rjiuzzol/True8Digit/README.md

# True8Digit
File repository for True8Digit project
