rjiuzzol/True8Digit/Documents/Main_copa_report_v2.pdf

## True8Digit project: COPA input amplifier characterization

Ricardo Iuzzolino¹ and Luis Palafox²

1
Instituto Nacional de Tecnolog´ıa Inductrial (INTI) - Argentina 2Physikalisch-Technische Bundesanstalt (PTB) - Germany

August 2024

## Contents

1 Introduction | 1
2 Test on Board #2 | 2
3 Tests on Board #1 | 3
4 Modification: changing the TL071 with OPA1655 | 10
5 Summary | 11
6 Appendix | 12

## 1 Introduction

Two identical boards were designed by INTI, built by CTU and delivered to PTB for testing:

Board #1

Board #2

Both boards are based on the schematic circuit depicted in figure 1, the original schematic circuit can be seen at reference [3]. The circuit is based on the original input amplifier of the DVM HP3458A [2].

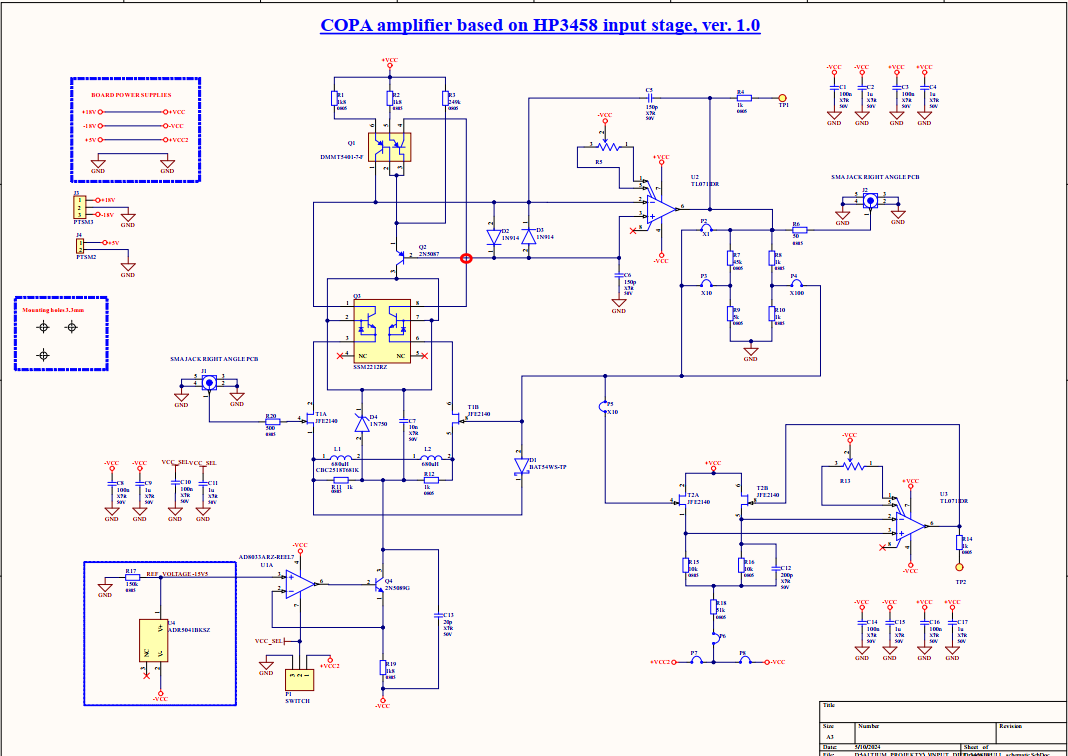
[picture p1: figure]

Figure 1: Schematic circuit based on LTSpice schematic ([3] and [1])

## 2 Test on Board #2

The gain, phase and total harmonic distortion (THD) as a function of input frequency were measured using the Audio Precision APx555 audio analyzer. Because on the of the digitizing channels is modified to have a high input impedance, the tests were run using channel two which has input impedance of 300 Ω, 600 Ω and 100 kΩ, therefore two sets of measures were done interchanging input and output channels. The APx555 offers the possibility of combining the peak of one acquisition with the rest of the spectrum acquired after a tuneable notch filter is adjusted to the measured frequency, thereby eliminating harmonics generated by the input stage of the digitizer.

### 2.1 Gain and Phase

A frequency sweep was set in order to obtain the gain and phase of the COPA amplifier, starting from 20 kHz down to 20 Hz in a linear sweep of 2000 points in total, keeping the signal amplitude fixed to the full scale value of 7.071 V to cover the full input range between ± 10 V.

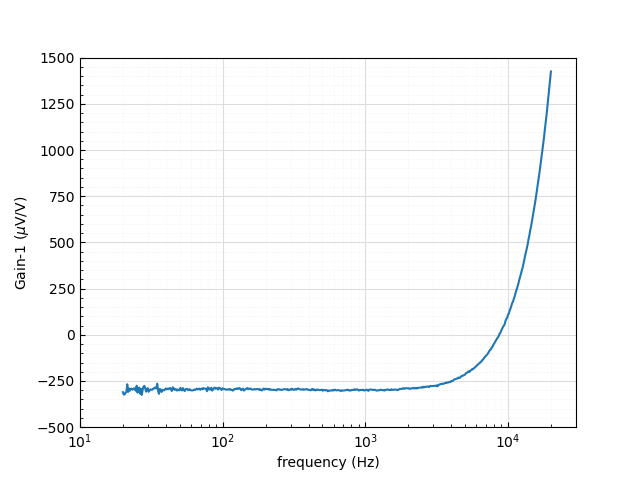
[picture p2: figure]
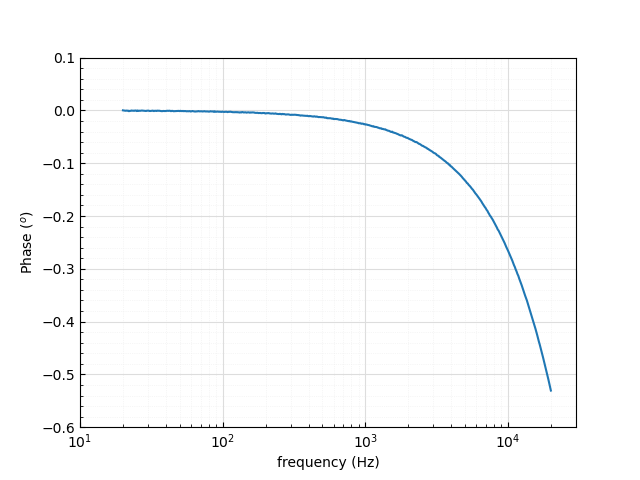
[picture p3: figure]

(a) COPA amplifier board #2 measured gain | (b) COPA amplifier board #2 phase response

### 2.2 Total Harmonic Distortion

To measure and estimate the total harmonic distortion, the APx555 channel 2 was used to measured first the input and then the output at the frequencies listed in table 1. A full scale amplitude signal was applied to the amplifier input, that is an RMS amplitude of 7.071 V, then the THD was obtained taking into account up to the 5th harmonic.

Table 1: Harmonic Distortion results for the input and output of the amplifier including the bandwidth resulting from the sampling rate used.

Freq (Hz) | Input THD (dB) | Output THD (dB) | Bandwidth
62.5 125 625 1000 2000 5000 10000 20000 | -150.41 -147.16 -149.28 -146.91 -142.02 -136.02 -130.61 -126.16 | -143.59 -138.61 -127.87 -123.81 -117.43 -108.56 -99.00 -88.38 | DC-90 kHz
50000 100000 | -118.43 -109.37 | -73.15 -46.15 | DC-500 kHz

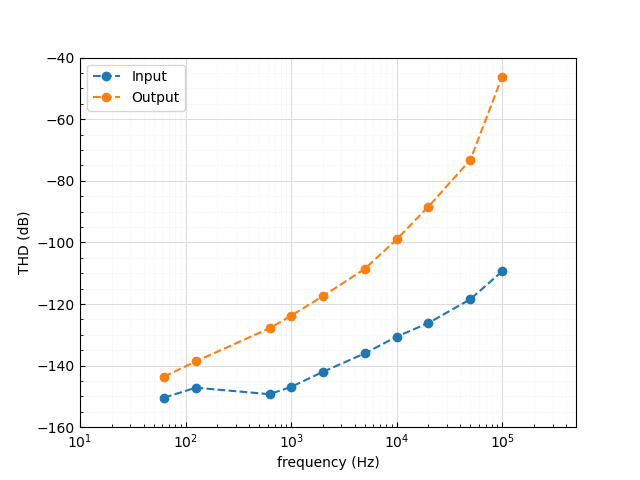
[picture p4: figure]

Figure 3: Total Harmonic Distortion of the circuit in figure 1 as a function of frequency

## 3 Tests on Board #1

Board #1 was modified as follows: the gain setting feedback resistors were removed, therefore only Gain = 1 is possible, the bootstrap circuit was disconnected from the main amplifier output because the BOOT signal is not routed on the PCB. Figure 4 depicts the circuit.

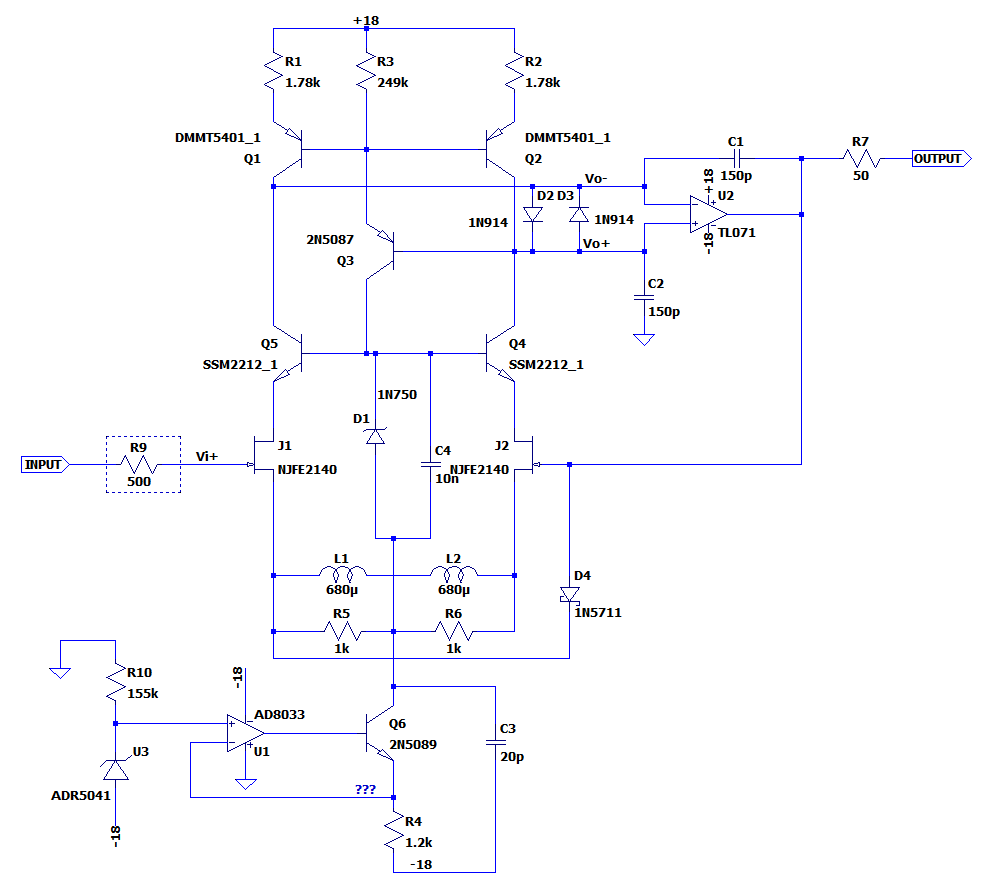
[picture p5: figure]

Figure 4: Schematic circuit of modified board #1

### 3.1 Gain and Phase

A linear frequency sweep with 2000 points was performed in order to obtain the response of the COPA amplifier, starting from 20 kHz down to 20 Hz, keeping the signal amplitude fixed to the full scale value of 7.071 V to cover the full input range between ± 10 V.

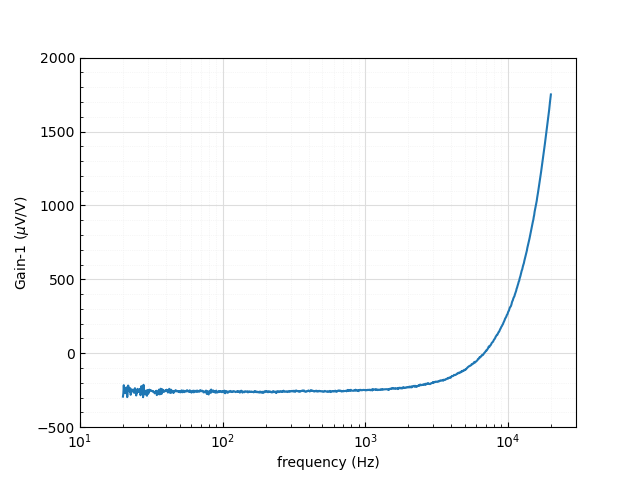
[picture p6: figure]
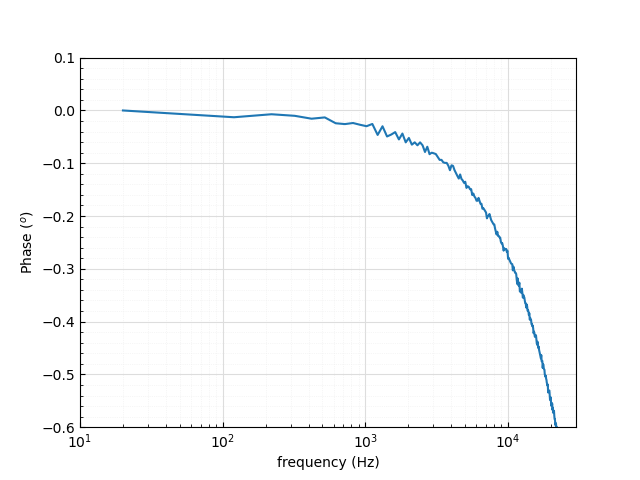
[picture p7: figure]

(a) COPA amplifier board #1 measured gain | (b) COPA amplifier board #1 phase response

### 3.2 Total Harmonic Distortion

The Total harmonic distortion test using up to the 5th harmonic was also performed for board #1. And was calculated using the same criteria as in section 2.2.

Table 2: Harmonic Distortion results for the input
and output of the amplifier including the bandwidth resulting from the sampling rate used.
Freq (Hz) (Hz) | Input THD (dB) | Output THD (dB) | Bandwidth
62.5 125 625 1000 2000 5000 10000 20000 | -151.22 -147.47 -151.36 -147.92 -142.79 -135.40 -130.60 -125.85 | -148.51 -144.36 -137.55 -134.14 -127.30 -115.48 -103.88 -92.42 | DC-90 kHz
50000 100000 | -118.87 -109.63 | -76.48 -45.13 | DC-500 kHz

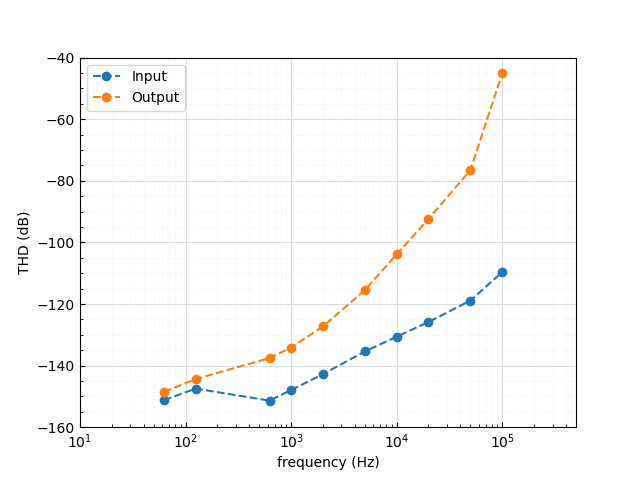
[picture p8: figure]

Figure 6: Total Harmonic Distortion as a function of frequency

### 3.2.1 Total Harmonic Distortion - Comparison

Figure 7 shows the THD of both boards, it is clear to see the improvements when removing the gain resistors and disconnecting the bootstrap circuit.

Table 3: Total Harmonic Distortion differences. THD 1 - THD 2

freq. (Hz) | Diff. (dB)
62.5 125 625 1000 2000 5000 10000 20000 50000 | 4.92 5.75 9.68 10.33 9.87 6.92 4.88 4.04 3.34

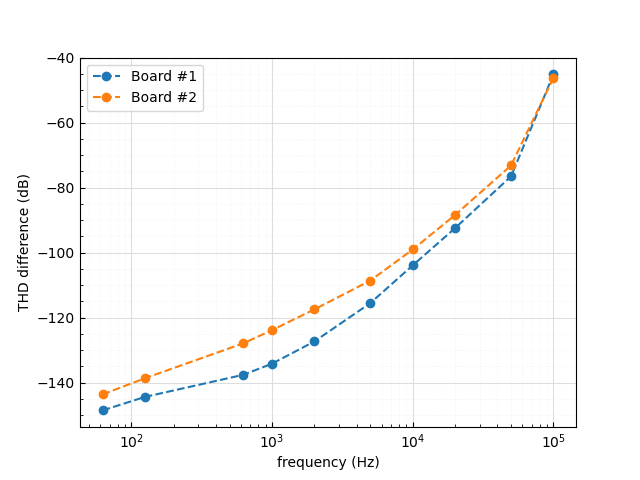
[picture p9: figure]

100000 | -1.02 | Figure 7: Board #1 and board #2 THD compar- ison

### 3.2.2 Harmonic distortion at different input signal levels

In order to characterize the harmonic distortion at different input signal frequencies and levels a test changing the input signal level while keeping the signal frequency constant was carried out as depicted in figure 8 for frequencies between 5 kHz and 100 kHz.

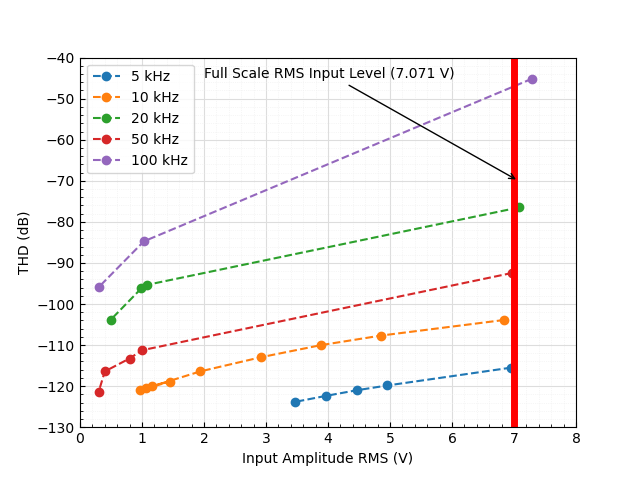
[picture p10: figure]

Figure 8: Total harmonic distortion vs. input signal level

### 3.2.3 Loading effect in the output spectrum

In order to evaluate the effect of loading at the output of the amplifier, the input impedance of the APx55 digitizer was changed between 600 Ω and 100 kΩ. The output spectra are depicted in figure 9

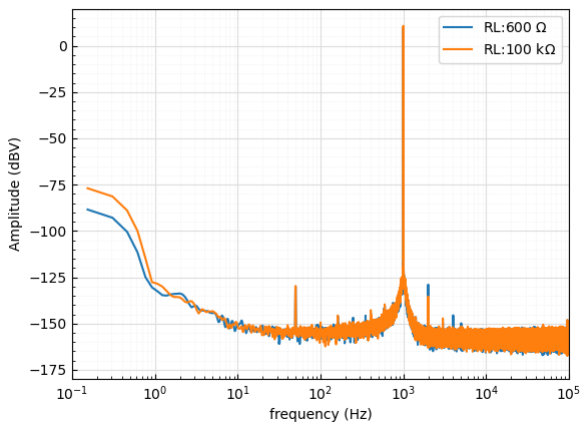
[picture p11: figure]
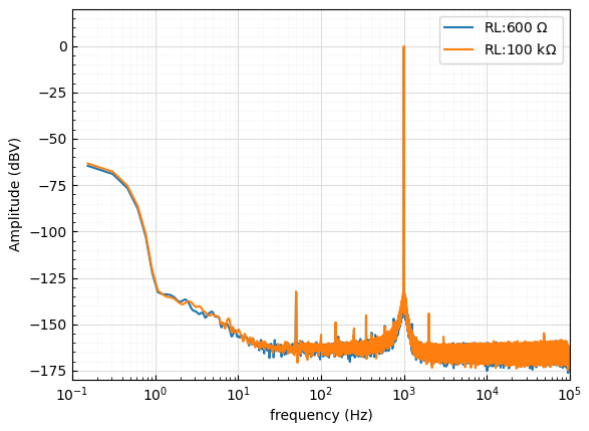
[picture p12: figure]

(a) Amplifier Spectrum Input Level 1 V | (b) Amplifier Spectrum Input Level 3.5 V

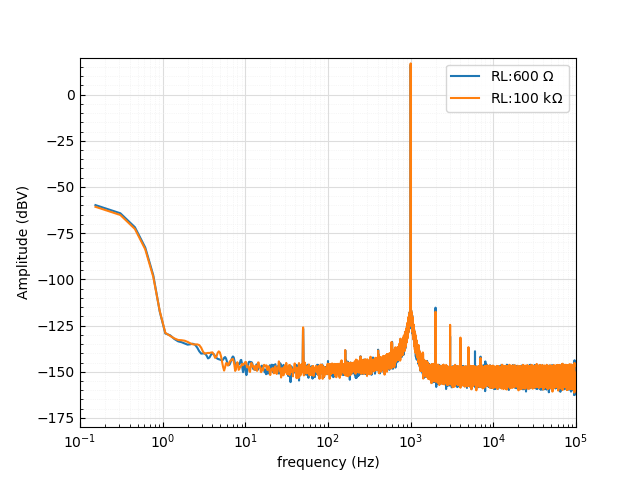
[picture p13: figure]

(c) Amplifier Spectrum Input Level 7.07 V

Figure 9: COPA Amplifer spectra at different loads values and input amplitudes

Test results are shown in table 4 where the input signal amplitude was set to 1 V RMS, in table 5 were the input amplitude was set to 3.5 V RMS and in table 6 were the input amplitude was set to 7.07 V RMS which corresponds to the amplifier full scale. The intermediate level was chosen to match the full scale value of the AD4630-24 SAR also analyzed in the project.

Table 4: Output levels at different frequencies for an input amplitude 1 V at 600 Ω and 100 kΩ loads

Harm. # | Freq (Hz) | 100 kΩ | 600 Ω | Delta
| | Amp (dB) | Amp | Amp (dB) | Amp
fo 2fo 3fo 4fo | 1000.20 2000.20 3000.30 4000.10 | -0.12816 -144.15 -156.63 -162.09 | 0.985353 V 62 nV 14.7 nV 7.86 nV | -0.82809 -149.05 -159 -162.08 | 0.909066 V 35.3 nV 11.2 nV 7.87 nV | 76 mV 26.7 nV 3.52 nV -4.48 pV

Table 5: Output levels at different frequencies for an input amplitude 3.5 V at 600 Ω and 100 kΩ loads

Harm. # | Freq (Hz) | 100 kΩ | 600 Ω | Delta
| | Amp (dB) | Amp | Amp (dB) | Amp
fo 2fo 3fo 4fo | 1000.15 2000.15 3000.30 4000.46 | 10.748 -135.39 -147.197 -154.121 | 3.446672 V 170 nV 43.7 nV 19.7 nV | 10.049 -128.985 -149.577 -145.531 | 3.180168 V 355 nV 33.2 nV 52.9 nV | 267 mV -185 nV 10.5 nV -33.2 nV

Table 6: Output levels at different frequencies for an input amplitude 7.07 V at 600 Ω and 100 kΩ loads

Harm. # | Freq (Hz) | 100 kΩ | 600 Ω | Delta
| | Amp (dB) | Amp | Amp (dB) | Amp
fo 2fo 3fo 4fo | 1000.15 2000.15 3000.30 4000.46 | 16.859 -117.537 -124.607 -131.498 | 6.965463 V 1.33 µV 0.588 µV 0.266 µV | 16.158 -115.307 -130.852 -135.219 | 6.425398 V 1.72 µV 0.287 µV 0.173 µV | 540 mV -389 nV 302 nV 92.7 nV

### 3.3 Noise

### 3.3.1 Equivalent input voltage noise

The input noise of the APx555 is comparable to the expected noise from the COPA, therefore PTB’s PA3 was used to amplify the noise of the COPA and connected as follows: the COPA amplifier input was shorted and the output connected to a pre-amplifier (PTB PA3 Ultra Low Noise AC pre-amplifier) running both on batteries. The PTB PA3 on its internal batteries and the COPA powered by a ±12 V battery pack. The PA3 output was connected to CH2 sampler. The AP software was configure to sample the data at 192 kHz (bandwidth DC to 90 kHz), averaging 64 windows of 1.2 M data points with rectangular windows (no window function on the software).
PA3 nominal gain = x60, measured gain = x59.2 and voltage noise = 0.53 nV/√
Hz. PA3 voltage
noise is shown in figure 11, as can be seen its noise level does not affect COPA noise measurements. Figure 10a shows the Amplitude Spectrum Density of the measured signal divided by the PA3 gain factor. The noise level at 1 kHz was determined to be 3.9 nV/√
Hz.

### 3.3.2 Equivalent input current noise

The short circuit in the above setup was substituted with a 100 MΩ resistor. Figure 10b shows the Amplitude Spectrum Density of the measured signal divided by the PA3 gain factor and 100 MΩ resistance. The current noise level at 1 kHz was determined to be 6.6 fA/√
Hz.

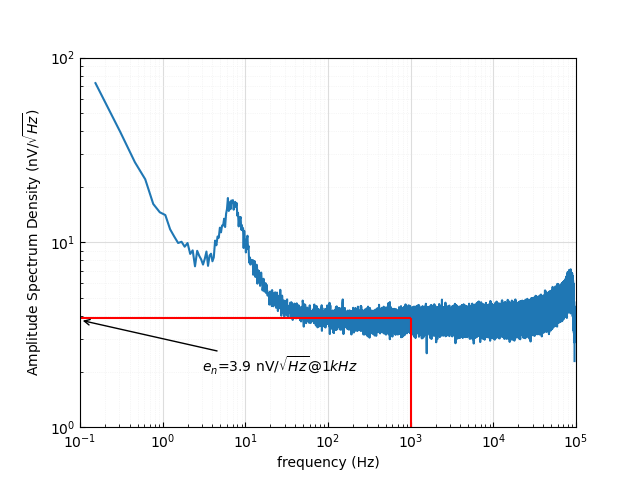
[picture p14: figure]
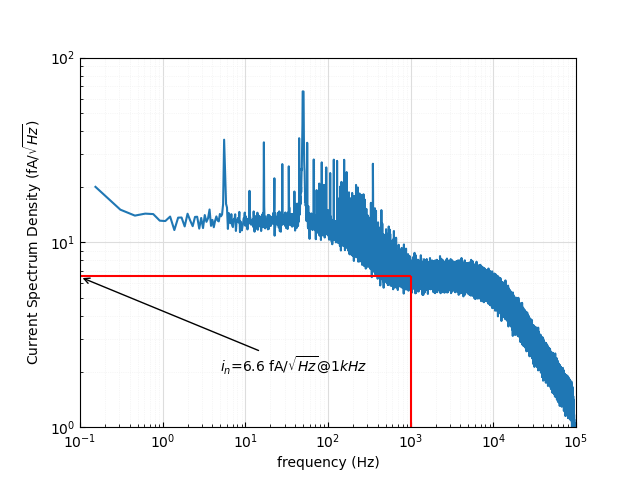
[picture p15: figure]

(a) COPA amplifier board #1 input voltage noise | (b) COPA amplifier board #1 input current noise

Figure 10: Amplifer voltage and current input reference noise

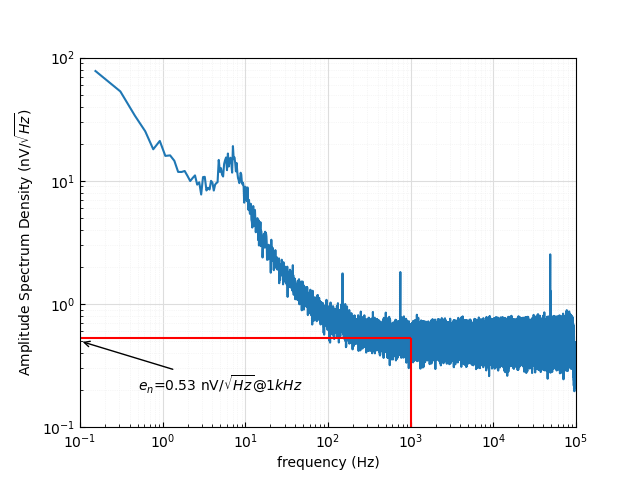
[picture p16: figure]

Figure 11: PA3 amplifier input voltage noise

### 3.4 Input Impedance

The input impedance was measured adding an external 100 MΩ in series between the output of the APx555 and the input of the COPA. and calculating the amplifier input current and voltage. The input voltage applied was 5 V RMS, then the amplifier input and output were measured by the AP on channel 2 in two steps: i) performing a frequency sweep from 20 Hz to 20 kHz (digitizer BW 90 kHz), ii) a second frequency sweep from 10 kHz up to 100 kHz (digitizer BW 250 kHz). Results are shown in figure 12 and table 7. The low frequency input impedance value results in 920.31 MΩ. Modelling the input impedance as an RC parallel circuit and performing a fitting to zero frequency an input resistance, Ri

, of 1.3645 GΩ and an input capacitance, Ci of 6.384 pF were determined.

Table 7: Board #1 Input Impedance

Freq (Hz) | Zi (MΩ)
20 1000 10000 20000 50000 100000 | 920.31 18.56 2.22 1.50 1.20 1.17

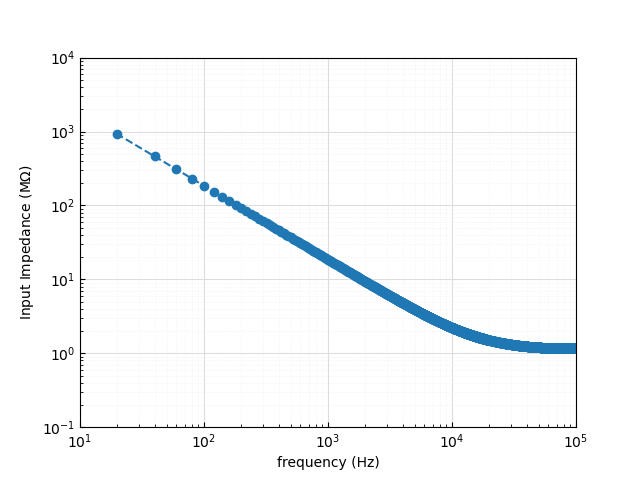
[picture p17: figure]

Figure 12: Board #1 input impedance in the frequency range from 20 Hz up to 100 kHz

Table 8: Input RC

Ri (GΩ) | Ci (pF)
1.364 | 6.38

### 3.5 Settling time

In order to obtain the amplifier settling time, a Keithley function generator was used as source, then the amplifier input and output were captured using a high bandwidth and high resolution digital scope

LeCroy, HDO4054, setting its digital filters to +3 bits which corresponds to a high resolution value. A squarewave signal with a peak-to-peak amplitude of 10 V and frequency of 10 kHz was used to observe and calculated the settling time. In addition, the rise-time and fall-time were calculated.

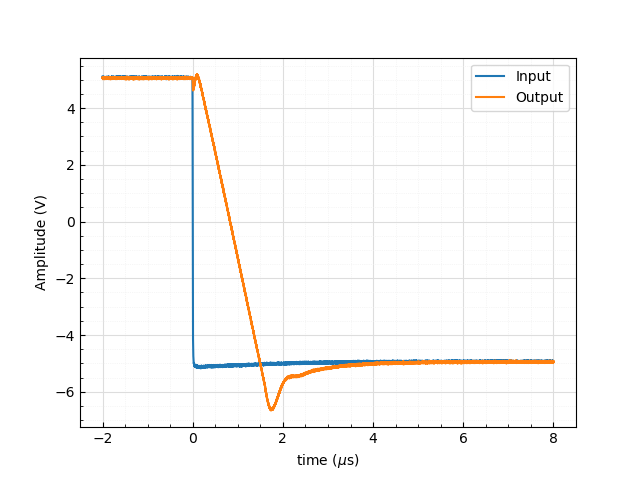
[picture p18: figure]
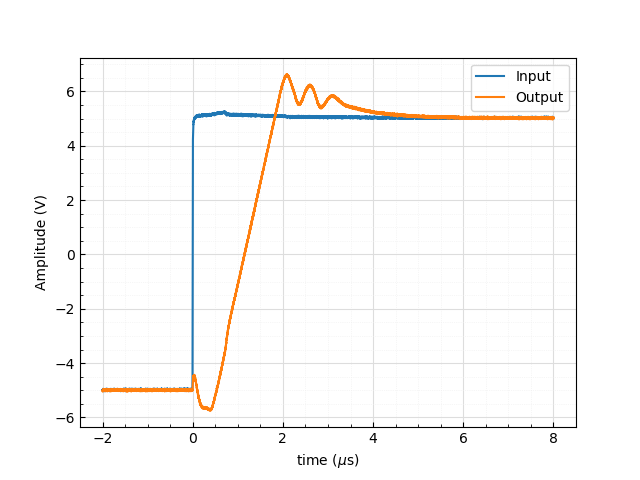
[picture p19: figure]

(a) Amplifier Rise time determined to be 1 µs | (b) Amplifier Fall time determined to be 1 µs

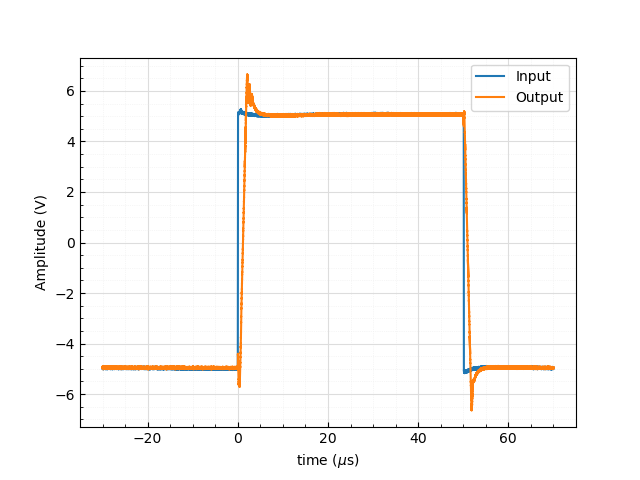
[picture p20: figure]
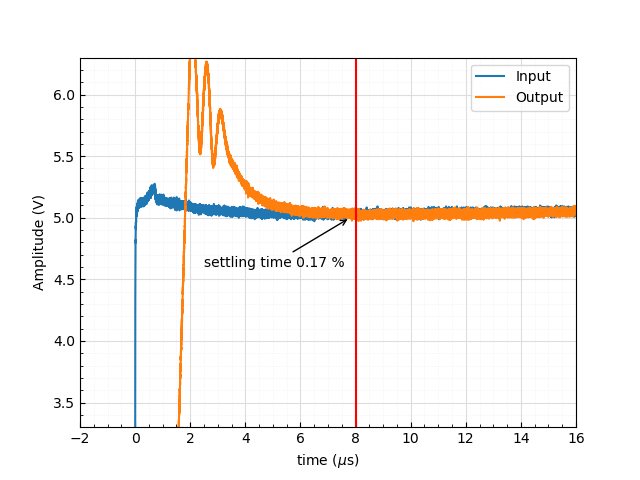
[picture p21: figure]

(c) Half period of the squarewave signal | (d) Measured settling time to 0.17 % in 8 µs

Figure 13: Rise-time, fall-time and settling time results

The determined settling time to 0.17 % in 8 µs can be seen in figure 13d. From figure 13a and 13b the observed rise and fall time (10 % - 90 %) are 1 µs which are limited by the second stage of the amplifier slew rate. Therefore, one improvement could be to replace the TL071 with a high slew rate operational amplifier.

## 4 Modification: changing the TL071 with OPA1655

Board # 2 was modified by replacing the TL071 [5] with an OPA1655 [4] with higher slew rate. Also, on this board the gain setting resistors and the boostrapping circuit were removed as for the board # 1. Therefore, there are two identical boards. Then, the total harmonic distortion was measured for frequencies 1 kHz, 5 kHz and 10 kHz with an amplitude RMS of 7.071 V. Results are depicted in table 9 and figure 14.

Table 9: THD of board #2 with OPA1655. Col-umn diff stands for the THD difference against board # 1

Freq (Hz) | THD (dB) | diff. (dB)
1000 5000 10000 | -123.547 -108.116 -99.065 | -10.59 -7.37 -4.81

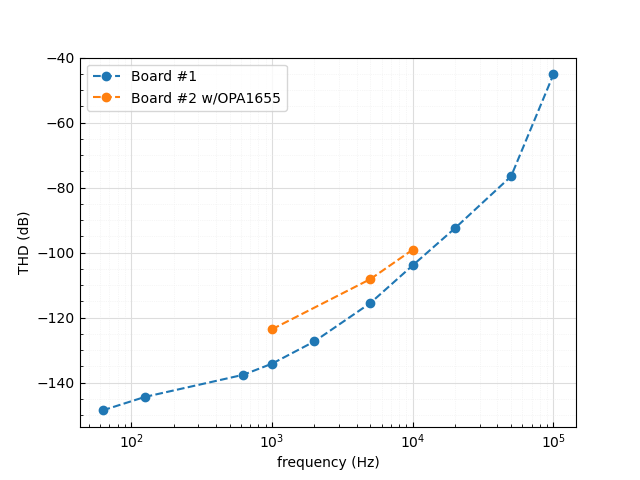
[picture p22: figure]

Figure 14: THD Board #1 and Board # 2 comparison

Then, to compare specifications with the amplifier datasheet its spectrum was calculated for input signals of 3.5 V RMS at 1 kHz and 20 kHz. The resulting spectra are depicted in figures 15a and 15b. The calculated THD are -128.96 dB at 1 kHz (before the change was -131 dB) and -94.27 dB at 20 kHz (before the change was -129 dB).

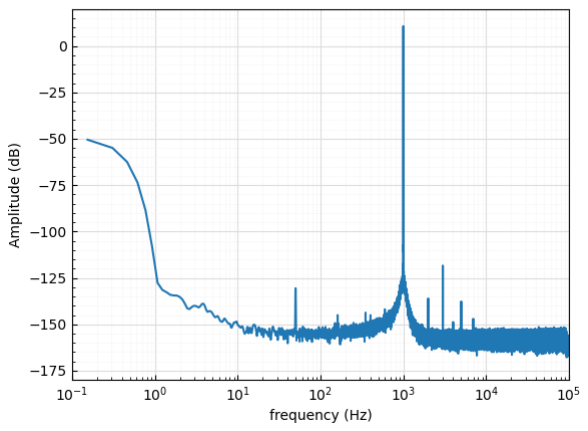
[picture p23: figure]
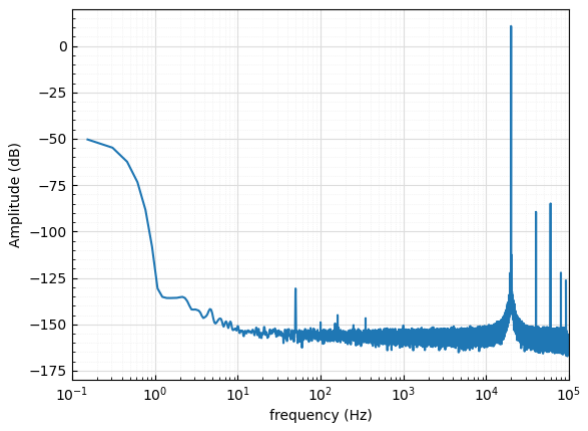
[picture p24: figure]

(a) Board # 2 spectrum 1 kHz 3.5 V RMS | (b) Board # 2 spectrum 20 kHz 3.5 V RMS

Figure 15: Output spectra of board # 2 with OPA1655 instead of TL071

## 5 Summary

Table 10 shows a summary of the measured features.

Table 10: Features measured results summary

Feature | Result
Gain @ 1 kHz | 0.999750 V/V
THD @ 1 kHz | -134.14 dB
en @ 1 kHz in @ 1 kHz | 3.9 nV/√ Hz 6.6 fA/√
| Hz
Zi (f=20 Hz) | 1.364 GΩ // 6.38 pF 920.31 MΩ
settling time | (0.17 %) (8.0 µs)
rise time (10 % - 90 %) | 1.0 µs
fall time (10 % - 90 %) | 1.0 µs

## References

[1] CTU. Copa pcb project. Altium-Project-COPA-Design, (https://nsai.sharepoint.com/:f:/r/sites/EMP-8digit/Shared%20Documents/WP2-COPAs%20and%20component%20characterisation/T2.1%20-%20COPAs%20Design%20%26%20Charact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) 2024. [Online; accessed 2024].
[2] Hewlett Packard. HP 3458 Multimeter Component Level Information Packet. Technical report, Hewlett Packard, 2001.
[3] INTI. Copa schematic circuit. InputDiff-3458A-FULL-RJI-03-TP, (https://nsai.sharepoint.com/:f:/r/sites/EMP-8digit/Shared%20Documents/WP2-COPAs%20and%20component%20characterisation/T2.1%20-%20COPAs%20Design%20%26%20Charact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) 2024. [Online; accessed 2024].
[4] Texas Instrument. OPA 1655 SoundPlus ultra-low noise and distortion, Burr-Brown single audio operational amplifier. OPA1655, (https://www.ti.com/lit/gpn/opa1655) 2022.
[5] Texas Instrument. TL07xx Low-Noise FET-Input Operational Amplifiers. TL071, (https://www.ti.com/lit/ds/slos080v/slos080v.pdf?ts=1723207536767) 2023.

## 6 Appendix

## LTSpice simulation results

In this section results from simulation are shown to be compared with the measured results, more simulation can be found at the sharepoint in the document simulation report. (https://nsai.sharepoint.com/:w:/r/sites/EMP-8digit/Shared%20Documents/WP2-COPAs%20and%20component%20characterisation/T2.1%20-%20COPAs%20Design%20%26%20Charact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)

Gain and Phase

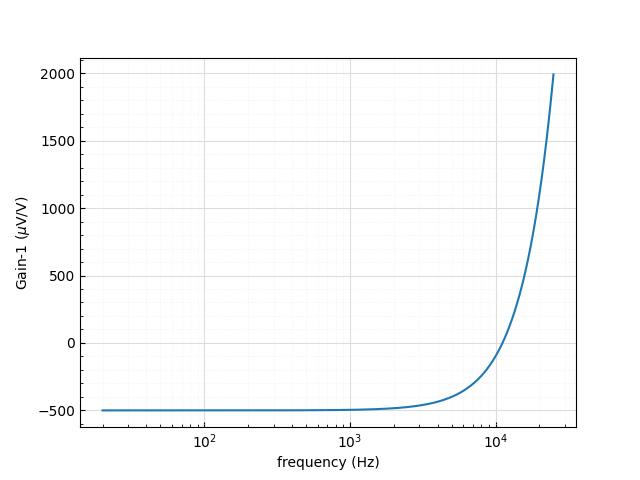
[picture p25: figure]
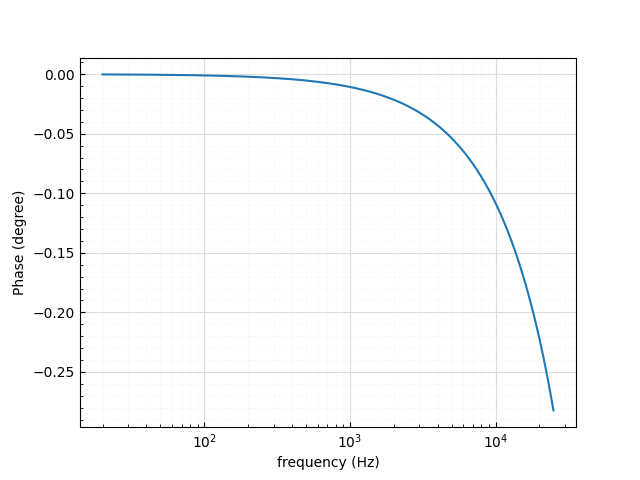
[picture p26: figure]

(a) COPA amplifier simulated gain | (b) COPA amplifier simulated phase displacement

Figure 16: COPA Simulated Gain and Phase

Output Spectrum and Total harmonic distortion

N-Period=80 Fourier components of V(vo) DC component:1.21365e-005

Harmonic Number | Frequency (Hz) | Amplitude (V) | Normalized Amplitude | Phase (◦ ) | Normalized Phase (◦ )
1 2 3 4 5 6 7 8 9 | 1000 2000 3000 4000 5000 6000 7000 8000 9000 | 9.995 3.071e-06 9.070e-07 3.200e-07 1.215e-07 4.834e-08 1.979e-08 8.263e-09 3.509e-09 | 1.000 3.073e-07 9.074e-08 3.202e-08 1.216e-08 4.836e-09 1.980e-09 8.267e-10 3.510e-10 | -0.01 5.80 -84.95 -172.64 98.86 10.39 -78.29 -166.94 104.07 | 0.00 5.80 -84.94 -172.64 98.87 10.40 -78.28 -166.93 104.07

Total Harmonic Distortion: 0.000032%(0.000000%). The calculated THD (dB) is equal to -129.83 dB.

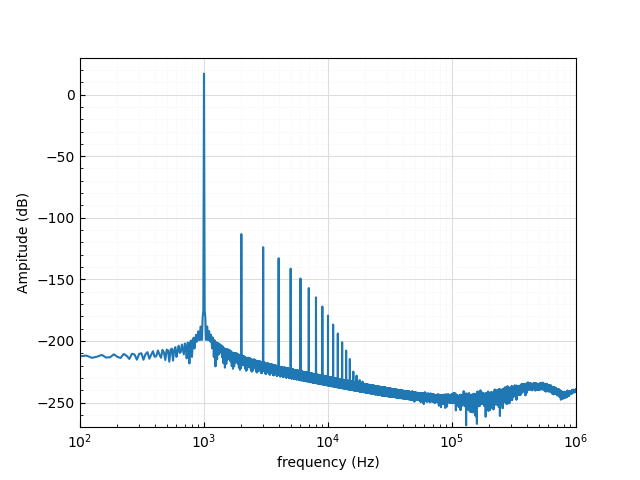
[picture p27: figure]

Figure 17: COPA amplifier simulated output spectrum for an input signal of 7.071 V RMS and 1 kHz frequency

Input Impedance

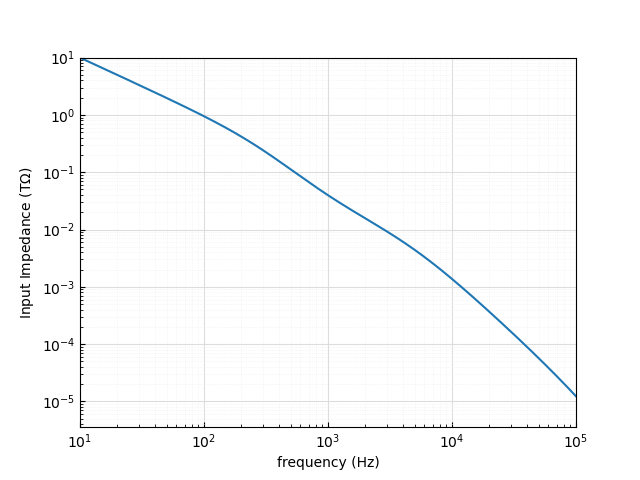
[picture p28: figure]

Figure 18: COPA amplifier simulated Input Impedance

Voltage Noise

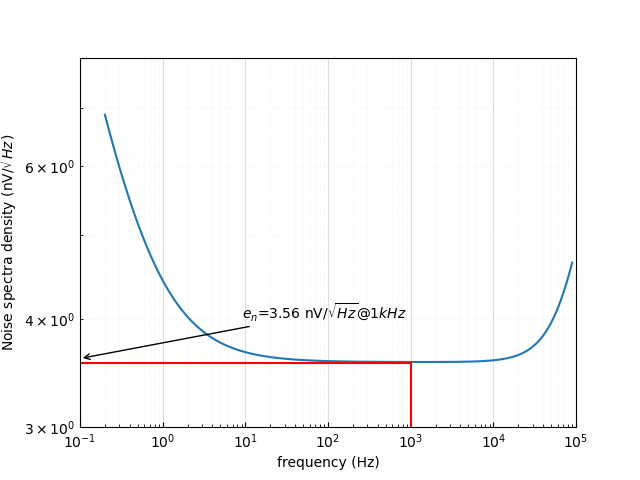
[picture p29: figure]

Figure 19: COPA amplifier simulated Input refered voltage Noise
