rjiuzzol/True8Digit/Timing_Platform/dataset/jitter_delay/TIEVM/TI_LMK05318BEVM-100MHz-20240913.pdf

# Measurement Report

2024-09-13T16:38:35+02:00

### Comments

LMK05318B EVM Jitter Measurement OUT0 100 MHz

### Setup Configuration

Scope Details
Scope Model Number | Scope Serial Number | TekScope Version | Scope Calibration Status
MSO64B | C069984 | 2.0.3 | Pass

### Waveform Histogram Results

No Waveform Histogram Results Available

### Measurement Results

Name | Measure ment | Src(s) | Mean' | Min' | Max' | Pk-Pk' | Std Dev' | Populatio n' | Accum Mean | Accum Min | Accum Max | Accum Pk-Pk | Accum Std Dev | Accum Pop
Meas 1 | JS: TIE(σ) | Ch 1 | -5.8827 fs | -5.6754 ps | 5.6100 ps 11.285 ps 1.2739 ps 1000001 | | | | -687.67 as | -7.1747 ps | 6.8110 ps 13.986 ps 1.2521 ps 14200014 | | | 2
| JS: TJ@ | Ch 1 | 15.345 ps 15.345 ps 15.345 ps 0.0000 s | | | | 0.0000 s | 1 | 15.510 ps 14.585 ps 16.487 ps 1.9019 ps 353.37 fs | | | | | 142
| JS: EW@ Ch 1 | | 9.9847 ns 9.9847 ns 9.9847 ns 0.0000 s | | | | 0.0000 s | 1 | 9.9845 ns 9.9835 ns 9.9854 ns 1.9019 ps 353.37 fs | | | | | 142
| JS: RJ-dd Ch 1 | | 895.86 fs | 895.86 fs | 895.86 fs | 0.0000 s | 0.0000 s | 1 | 885.24 fs | 870.19 fs | 902.13 fs | 31.938 fs | 9.3278 fs | 142
| JS: DJ-dd Ch 1 | | 2.7408 ps 2.7408 ps 2.7408 ps 0.0000 s | | | | 0.0000 s | 1 | 3.0557 ps 2.2763 ps 3.9579 ps 1.6817 ps 330.76 fs | | | | | 142
| JS: PJ | Ch 1 | 3.9059 ps 3.9059 ps 3.9059 ps 0.0000 s | | | | 0.0000 s | 1 | 4.2772 ps 3.5505 ps 5.3512 ps 1.8006 ps 375.46 fs | | | | | 142
| JS: DDJ | Ch 1 | 0.0000 s | 0.0000 s | 0.0000 s | 0.0000 s | 0.0000 s | 1 | 0.0000 s | 0.0000 s | 0.0000 s | 0.0000 s | 0.0000 s | 142
| JS: DCD | Ch 1 | 604.81 fs | 604.81 fs | 604.81 fs | 0.0000 s | 0.0000 s | 1 | 574.22 fs | 432.18 fs | 728.81 fs | 296.63 fs | 49.280 fs | 142
Meas2 | Frequenc y | Ch 1 | 100.00 MHz | 99.923 MHz | 100.08 MHz | 154.83 kHz | 17.491 kHz | 1000000 | 100.00 MHz | 99.912 MHz | 100.10 MHz | 183.89 kHz | 16.988 kHz | 14200000 0
Meas3 | Phase Noise | Ch 1 | 351.78 fs | 351.78 fs | 351.78 fs | 0.0000 s | 0.0000 s | 1 | 342.79 fs | 247.46 fs | 467.67 fs | 220.21 fs | 46.377 fs | 142

Views
Time Domain View

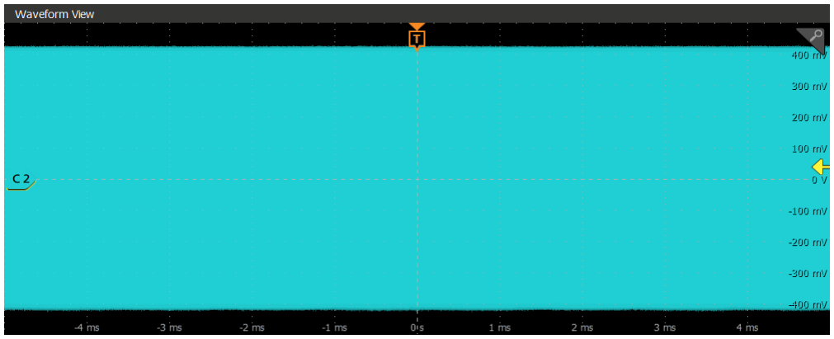
[picture p30: figure]

Plots

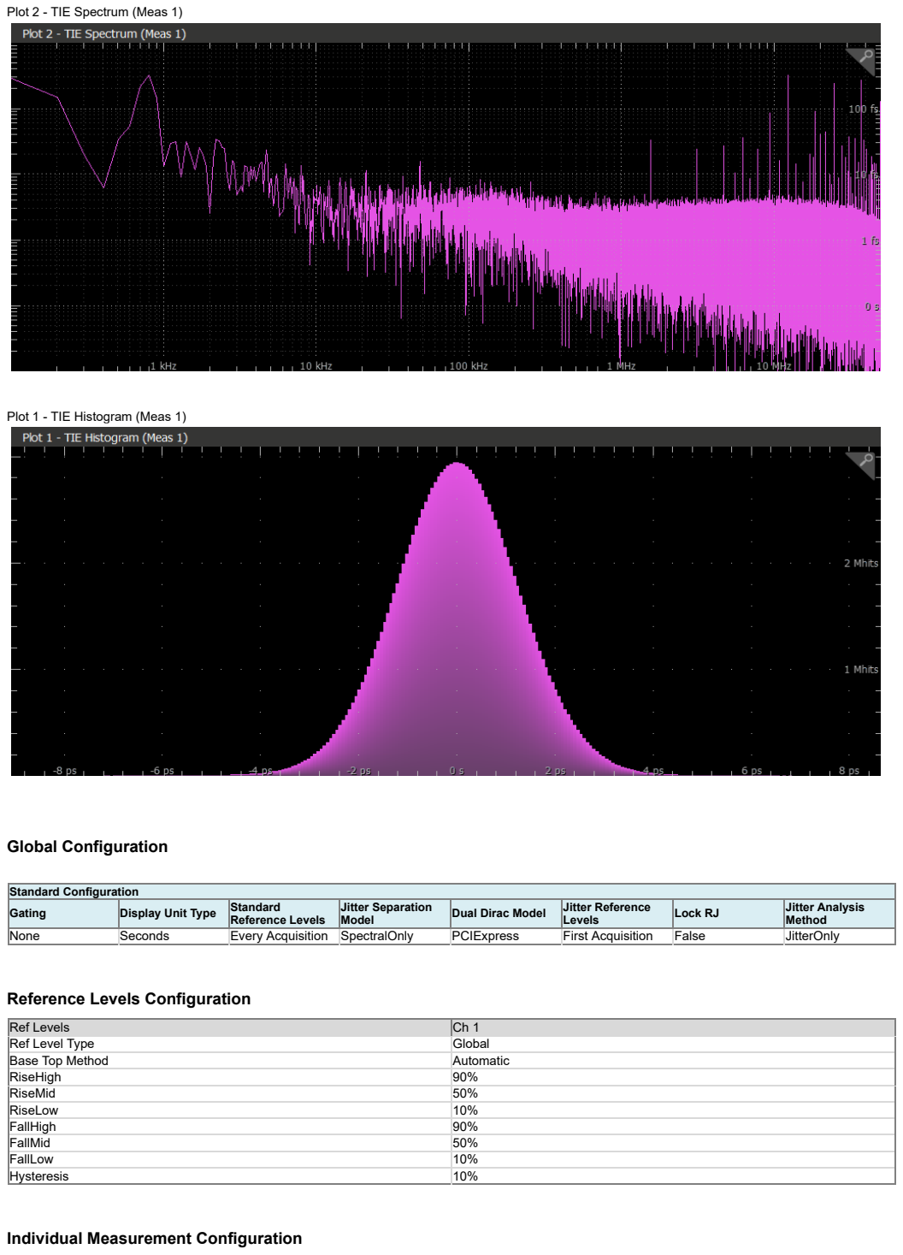
[picture p31: page 2]

### Global Configuration

Standard Configuration
Gating | Display Unit Type | Standard Reference Levels | Jitter Separation Model | Dual Dirac Model | Jitter Reference Levels | Lock RJ | Jitter Analysis Method
None | Seconds | Every Acquisition | SpectralOnly | PCIExpress | First Acquisition | False | JitterOnly

### Reference Levels Configuration

Ref Levels | Ch 1
Ref Level Type | Global
Base Top Method | Automatic
RiseHigh | 90%
RiseMid | 50%
RiseLow | 10%
FallHigh | 90%
FallMid | 50%
FallLow | 10%
Hysteresis | 10%

### Individual Measurement Configuration

Plot 2 - TIE Spectrum (Meas 1)

Plot 1 - TIE Histogram (Meas 1)

Meas 1 - Jitter Summary
Ref Levels | ClockRecovery | RjDj | Filter | Configurations | Gating
Ref Level Type | Local | Method | Constant Clock | Signal Type | Auto | Filter Spec-High Pass(F1) | No Filter | Custom Measureme nt Name | Jitter Summary | Gating Type | None
Source | Ch 1 | Mode | Mean | Clock Edge | RisingEdge | Filter Spec-Low Pass(F2) | No Filter
Base Top Method | Automatic | Calculated On | Every Acquisition | BER | 1E-12
RiseHigh | 80% | | | Pattern Detection | Manual
RiseMid | 50% | | | Pattern Type | Repeating
RiseLow | 20% | | | Pattern Length | 2 UI
FallHigh | 80%
FallMid | 50%
FallLow | 20%
Hysteresis | 5%

Meas2 - Frequency
Ref Levels | Edge | Filter | Configurations | Gating
Ref Level Type Global | | Edge | First | Filter Spec-High Pass(F1) | No Filter | Custom Measurement Name | Frequency | Gating Type | None
Source(s) | Ch 1 | | | Filter Spec-Low Pass(F2) | No Filter

Meas3 - Phase Noise
Ref Levels | ClockRecovery | Edge | Filter | Configurations | Gating
Ref Level Type | Global | Method | Constant Clock | Upper Noise Integration Limit | 1.0000 MHz | Filter Spec-High Pass(F1) | No Filter | Custom Measureme nt Name | Phase Noise | Gating Type | None
Source(s) | Ch 1 | Mode | Mean | Lower Noise Integration Limit | 0.0000 Hz | Filter Spec-Low Pass(F2) | No Filter
| | Calculated On | Every Acquisition
