rjiuzzol/True8Digit/Timing_Platform/dataset/jitter_delay/LMK04821Timing/50psDelay/Tek000.pdf

# Measurement Report

2025-12-12T12:20:50+01:00

### Setup Configuration

Scope Details
Scope Model Number | Scope Serial Number | TekScope Version | Scope Calibration Status
MSO64B | C069984 | 2.0.3 | Pass

### Waveform Histogram Results

No Waveform Histogram Results Available

### Measurement Results

Name | Meas | Sources | Mean' | Min' | Max' | Pk-Pk' | Std Dev' | Pop' | Accum Mean | Accum Min | Accum Max | Accum Pk-Pk | Accum Std Dev | Accum Pop
Meas1 | Frequenc y | Ch 1 | -- | -- | -- | -- | -- | 0 | -- | -- | -- | -- | -- | 0
Meas2 | Frequenc y | Ch 2 | 122.88 MHz | 122.88 MHz | 122.88 MHz | 0.0000 Hz | 0.0000 Hz | 1 | 122.88 MHz | 122.77 MHz | 123.01 MHz | 237.03 kHz | 32.982 kHz | 2475
Meas3 | Frequenc y | Ch 2 | 122.88 MHz | 122.88 MHz | 122.88 MHz | 0.0000 Hz | 0.0000 Hz | 1 | 122.88 MHz | 122.77 MHz | 123.01 MHz | 237.03 kHz | 32.982 kHz | 2475
Meas4 | Delay | Ch 2,Ch 3 | -89.935 ps | -89.935 ps | -89.935 ps | 0.0000 s | 0.0000 s | 1 | -90.189 ps | -151.38 ps | -24.788 ps | 126.59 ps 17.297 ps 2475

Views
Time Domain View

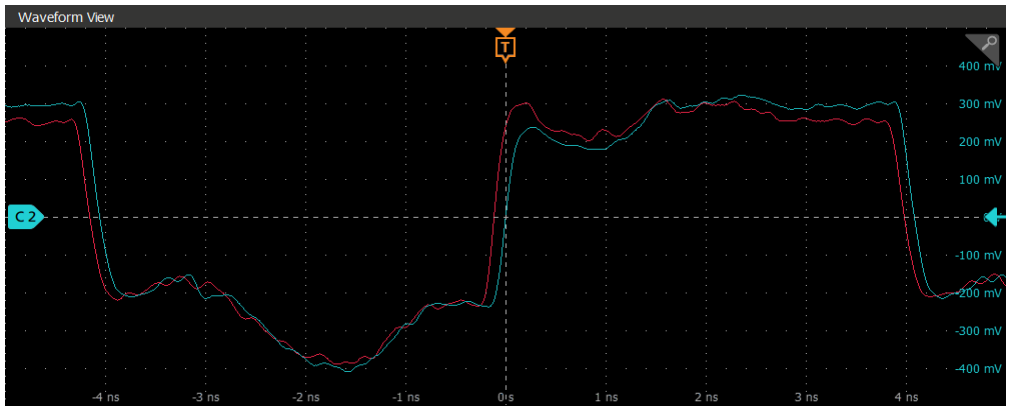
[picture p36: figure]

Plots

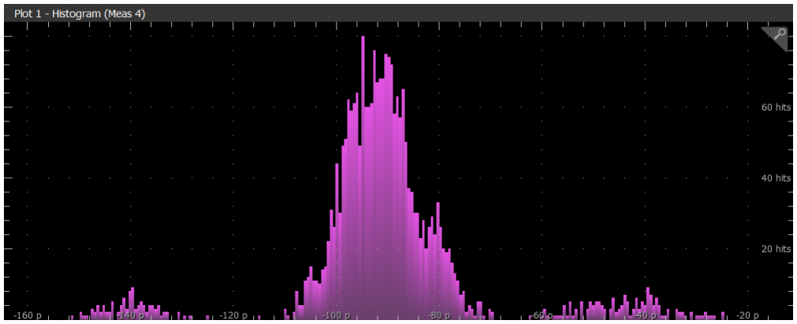
[picture p37: figure]

### Global Configuration

Standard Configuration
Gating | Display Unit Type | Standard Reference Levels | Jitter Separation Model | Dual Dirac Model | Jitter Reference Levels | Lock RJ | Jitter Analysis Method
None | Seconds | Every Acquisition | SpectralOnly | PCIExpress | First Acquisition | False | JitterOnly

### Reference Levels Configuration

Ref Levels | Ch 1, Ch 2, Ch 3
Ref Level Type | Global
Base Top Method | Automatic
RiseHigh | 90%
RiseMid | 50%
RiseLow | 10%
FallHigh | 90%
FallMid | 50%
FallLow | 10%
Hysteresis | 5%

### Individual Measurement Configuration

Meas1 - Frequency
Ref Levels | Edge | Filter | Configurations | Gating
Ref Level Type Global | | Edge | First | Filter Spec-High Pass(F1) | No Filter | Custom Measurement Name | Frequency | Gating Type | None
Source(s) | Ch 1 | | | Filter Spec-Low Pass(F2) | No Filter

Meas2 - Frequency
Ref Levels | Edge | Filter | Configurations | Gating
Ref Level Type Global | | Edge | First | Filter Spec-High Pass(F1) | No Filter | Custom Measurement Name | Frequency | Gating Type | None
Source(s) | Ch 2 | | | Filter Spec-Low Pass(F2) | No Filter

Meas3 - Frequency
Ref Levels | Edge | Filter | Configurations | Gating
Ref Level Type Global | | Edge | First | Filter Spec-High Pass(F1) | No Filter | Custom Measurement Name | Frequency | Gating Type | None
Source(s) | Ch 2 | | | Filter Spec-Low Pass(F2) | No Filter

Plot 1 - Histogram (Meas 4)

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
