rjiuzzol/True8Digit/Timing_Platform/dataset/jitter_delay/LMK04821Timing/Jitter/Tek000.pdf

# Measurement Report

2025-12-12T12:53:03+01:00

### Setup Configuration

Scope Details
Scope Model Number | Scope Serial Number | TekScope Version | Scope Calibration Status
MSO64B | C069984 | 2.0.3 | Pass

### Waveform Histogram Results

No Waveform Histogram Results Available

### Measurement Results

Name | Meas | Sources | Mean' | Min' | Max' | Pk-Pk' | Std Dev' | Pop' | Accum Mean | Accum Min | Accum Max | Accum Pk-Pk | Accum Std Dev | Accum Pop
Meas1 | TIE | Ch 2 | 3.2175 as -8.1844 | ps | 7.8749 ps 16.059 ps 2.0458 ps 12287 | | | | 202.43 zs -10.884 | ps | 11.011 ps | 21.895 ps 2.0700 ps 6720989
Meas2 | TIE | Ch 3 | 5.4504 as -7.9850 | ps | 7.7369 ps 15.722 ps 2.2905 ps 12288 | | | | 7.6674 zs -11.654 | ps | 10.724 ps 22.378 ps 2.2420 ps 6721536
Meas 3 | JS: TIE(σ) | Ch 3 | 5.4504 as -7.9850 | ps | 7.7369 ps 15.722 ps 2.2905 ps 12288 | | | | 7.6674 zs -11.654 | ps | 10.724 ps 22.378 ps 2.2420 ps 6721536
| JS: TJ@ | Ch 3 | 29.421 ps 29.421 ps 29.421 ps 0.0000 s | | | | 0.0000 s | 1 | 29.049 ps 15.371 ps 30.887 ps 15.516 ps 1.7855 ps 547
| JS: EW@ Ch 3 | | 8.1086 ns 8.1086 ns 8.1086 ns 0.0000 s | | | | 0.0000 s | 1 | 8.1090 ns 8.1071 ns 8.1226 ns 15.516 ps 1.7855 ps 547
| JS: RJ-dd Ch 3 | | 1.8748 ps 1.8748 ps 1.8748 ps 0.0000 s | | | | 0.0000 s | 1 | 1.8323 ps 961.38 fs | | 1.9192 ps 957.79 fs | | 113.49 fs | 547
| JS: DJ-dd Ch 3 | | 3.0443 ps 3.0443 ps 3.0443 ps 0.0000 s | | | | 0.0000 s | 1 | 3.2700 ps 1.7435 ps 4.3925 ps 2.6490 ps 406.82 fs | | | | | 547
| JS: PJ | Ch 3 | 5.8706 ps 5.8706 ps 5.8706 ps 0.0000 s | | | | 0.0000 s | 1 | 5.6974 ps 3.0556 ps 7.3997 ps 4.3441 ps 614.40 fs | | | | | 547
| JS: DDJ | Ch 3 | 0.0000 s | 0.0000 s | 0.0000 s | 0.0000 s | 0.0000 s | 1 | 0.0000 s | 0.0000 s | 0.0000 s | 0.0000 s | 0.0000 s | 547
| JS: DCD | Ch 3 | 0.0000 s | 0.0000 s | 0.0000 s | 0.0000 s | 0.0000 s | 1 | 24.278 fs | 0.0000 s | 364.52 fs | 364.52 fs | 59.986 fs | 547
Meas 4 | JS: TIE(σ) | Ch 2 | 3.2175 as -8.1844 | ps | 7.8749 ps 16.059 ps 2.0458 ps 12287 | | | | 202.43 zs -10.884 | ps | 11.011 ps | 21.895 ps 2.0700 ps 6720989
| JS: TJ@ | Ch 2 | 27.532 ps 27.532 ps 27.532 ps 0.0000 s | | | | 0.0000 s | 1 | 27.967 ps 26.746 ps 29.328 ps 2.5815 ps 477.40 fs | | | | | 547
| JS: EW@ Ch 2 | | 8.1105 ns 8.1105 ns 8.1105 ns 0.0000 s | | | | 0.0000 s | 1 | 8.1101 ns 8.1087 ns 8.1113 ns | | | 2.5815 ps 477.40 fs | | 547
| JS: RJ-dd Ch 2 | | 1.8452 ps 1.8452 ps 1.8452 ps 0.0000 s | | | | 0.0000 s | 1 | 1.8400 ps 1.7698 ps 1.9214 ps 151.63 fs | | | | 26.204 fs | 547
| JS: DJ-dd Ch 2 | | 1.5716 ps 1.5716 ps 1.5716 ps 0.0000 s | | | | 0.0000 s | 1 | 2.0799 ps 1.3638 ps 3.2198 ps 1.8560 ps 322.64 fs | | | | | 547
| JS: PJ | Ch 2 | 3.5570 ps 3.5570 ps 3.5570 ps 0.0000 s | | | | 0.0000 s | 1 | 4.2178 ps 2.7463 ps 5.7922 ps 3.0459 ps 489.71 fs | | | | | 547
| JS: DDJ | Ch 2 | 0.0000 s | 0.0000 s | 0.0000 s | 0.0000 s | 0.0000 s | 1 | 0.0000 s | 0.0000 s | 0.0000 s | 0.0000 s | 0.0000 s | 547
| JS: DCD | Ch 2 | 0.0000 s | 0.0000 s | 0.0000 s | 0.0000 s | 0.0000 s | 1 | 23.468 fs | 0.0000 s | 307.10 fs | 307.10 fs | 57.949 fs | 547

Views
Time Domain View

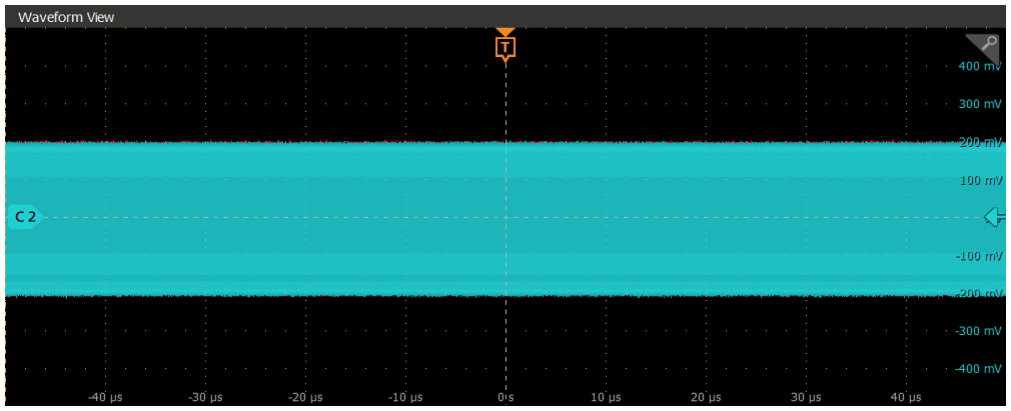
[picture p38: figure]

Plots

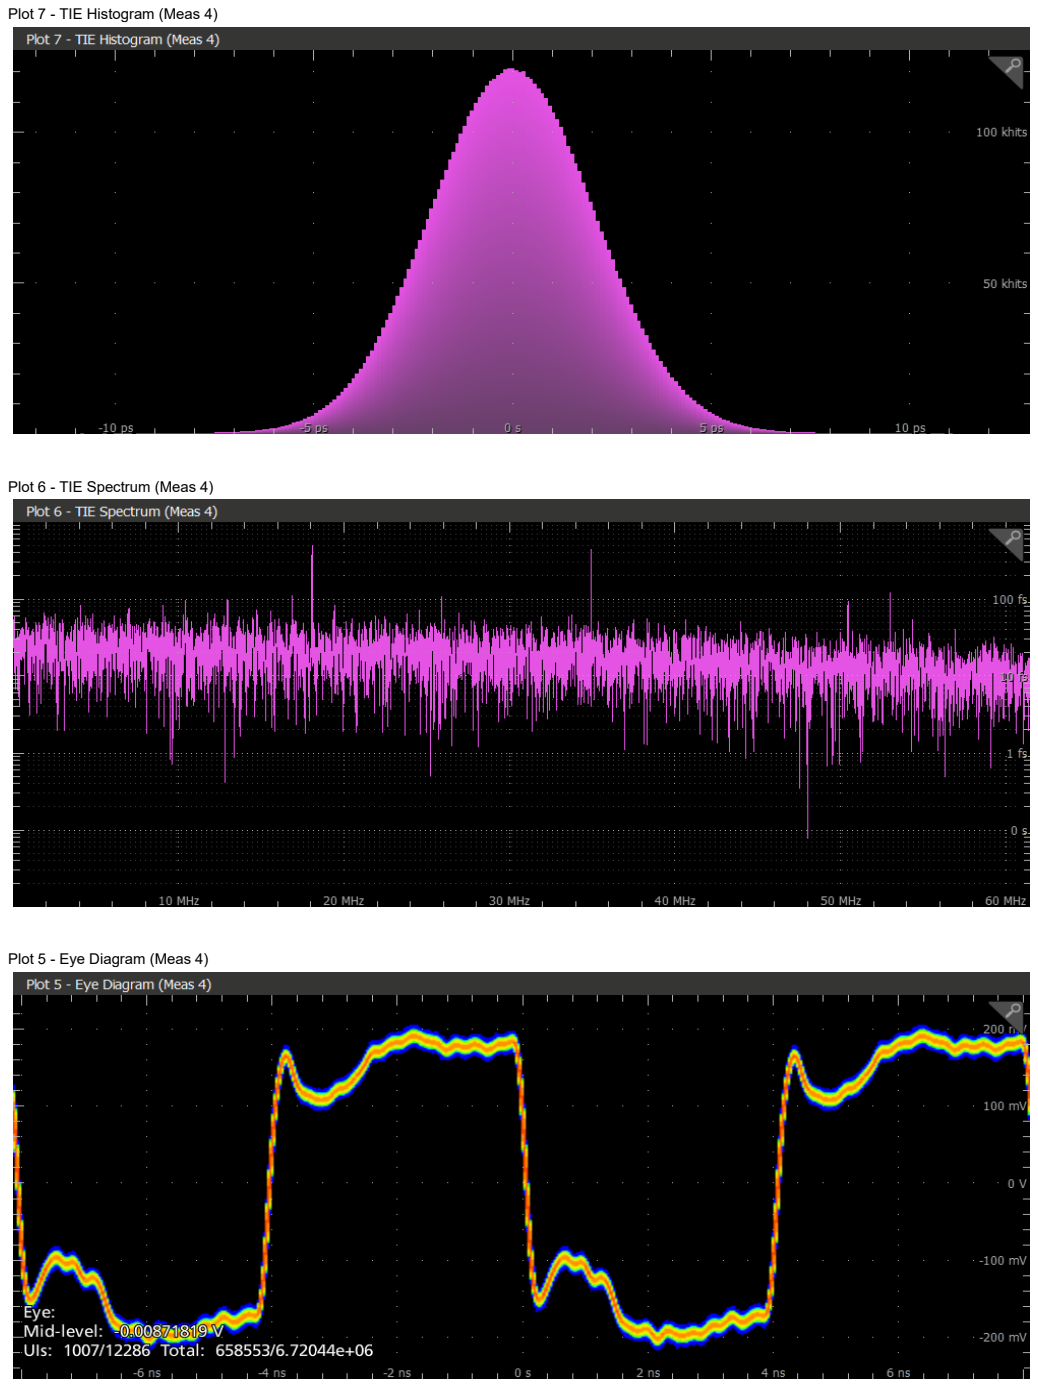
[picture p39: page 2]

Plot 7 - TIE Histogram (Meas 4)

Plot 6 - TIE Spectrum (Meas 4)

Plot 5 - Eye Diagram (Meas 4)

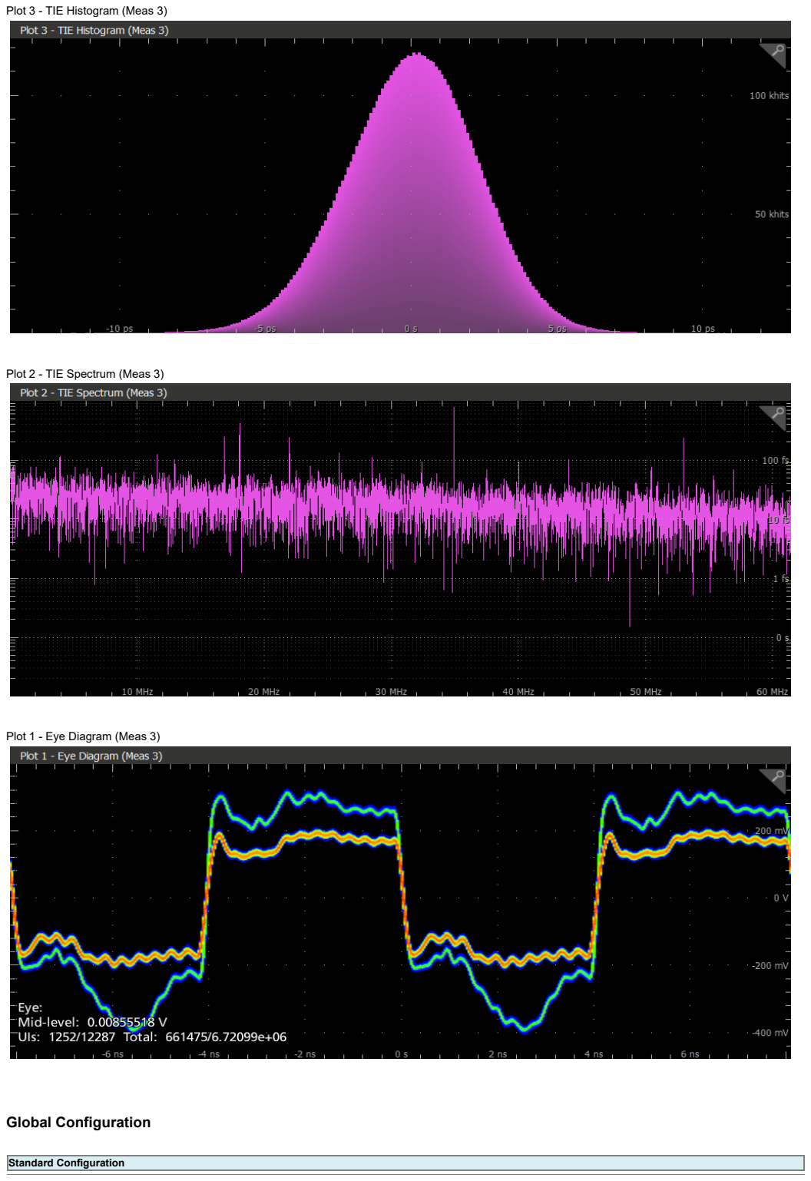
[picture p40: page 3]

### Global Configuration

Standard Configuration

Plot 3 - TIE Histogram (Meas 3)

Plot 2 - TIE Spectrum (Meas 3)

Plot 1 - Eye Diagram (Meas 3)

Gating Standard Configuration | Display Unit Type | Standard | Jitter Separation Model | Dual Dirac Model | Jitter Reference | Lock RJ | Jitter Analysis Method
| | Reference Levels | | | Levels
Gating | Display Unit Type | Standard Reference Levels | Jitter Separation Model | Dual Dirac Model | Levels | Lock RJ | Jitter Analysis Method
None | Seconds | Every Acquisition | SpectralOnly | PCIExpress | First Acquisition | False | JitterOnly

Jitter Reference

### Reference Levels Configuration

Ref Levels | Ch 2, Ch 3
Ref Level Type | Global
Base Top Method | Automatic
RiseHigh | 90%
RiseMid | 50%
RiseLow | 10%
FallHigh | 90%
FallMid | 50%
FallLow | 10%
Hysteresis | 5%

### Individual Measurement Configuration

Meas1 - TIE
Ref Levels | ClockRecovery | Edge | Filter | Configurations | Gating
Ref Level Type | Global | Method | Constant Clock | Signal Type | Auto | Filter Spec-High Pass(F1) | No Filter | Custom Measureme nt Name | TIE | Gating Type | None
Source(s) | Ch 2 | Mode | Mean | Clock Edge | RisingEdge | Filter Spec-Low Pass(F2) | No Filter
| | Calculated On | Every Acquisition

Meas2 - TIE
Ref Levels | ClockRecovery | Edge | Filter | Configurations | Gating
Ref Level Type | Global | Method | Constant Clock | Signal Type | Auto | Filter Spec-High Pass(F1) | No Filter | Custom Measureme nt Name | TIE | Gating Type | None
Source(s) | Ch 3 | Mode | Mean | Clock Edge | RisingEdge | Filter Spec-Low Pass(F2) | No Filter
| | Calculated On | Every Acquisition

Meas 3 - Jitter Summary
Ref Levels | ClockRecovery | Filter | Configurations | Gating
Ref Level Type Global | | Method | Constant Clock | Filter Spec-High Pass(F1) | No Filter | Custom Measurement Name | Jitter Summary Gating Type | None
Source(s) | Ch 3 | Mode | Mean | Filter Spec-Low Pass(F2) | No Filter
| | Calculated On | Every Acquisition

Meas 4 - Jitter Summary
Ref Levels | ClockRecovery | Filter | Configurations | Gating
Ref Level Type Global | | Method | Constant Clock | Filter Spec-High Pass(F1) | No Filter | Custom Measurement Name | Jitter Summary Gating Type | None
Source(s) | Ch 2 | Mode | Mean | Filter Spec-Low Pass(F2) | No Filter
| | Calculated On | Every Acquisition
