rjiuzzol/True8Digit/COPA/dataset_1/Soft_screenshots.pptx

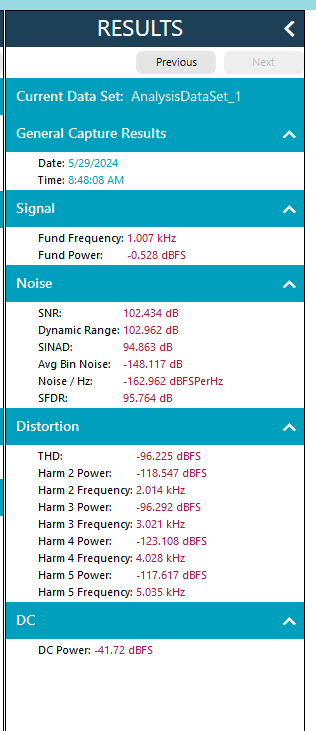
[picture p41: figure]

## Slide 2

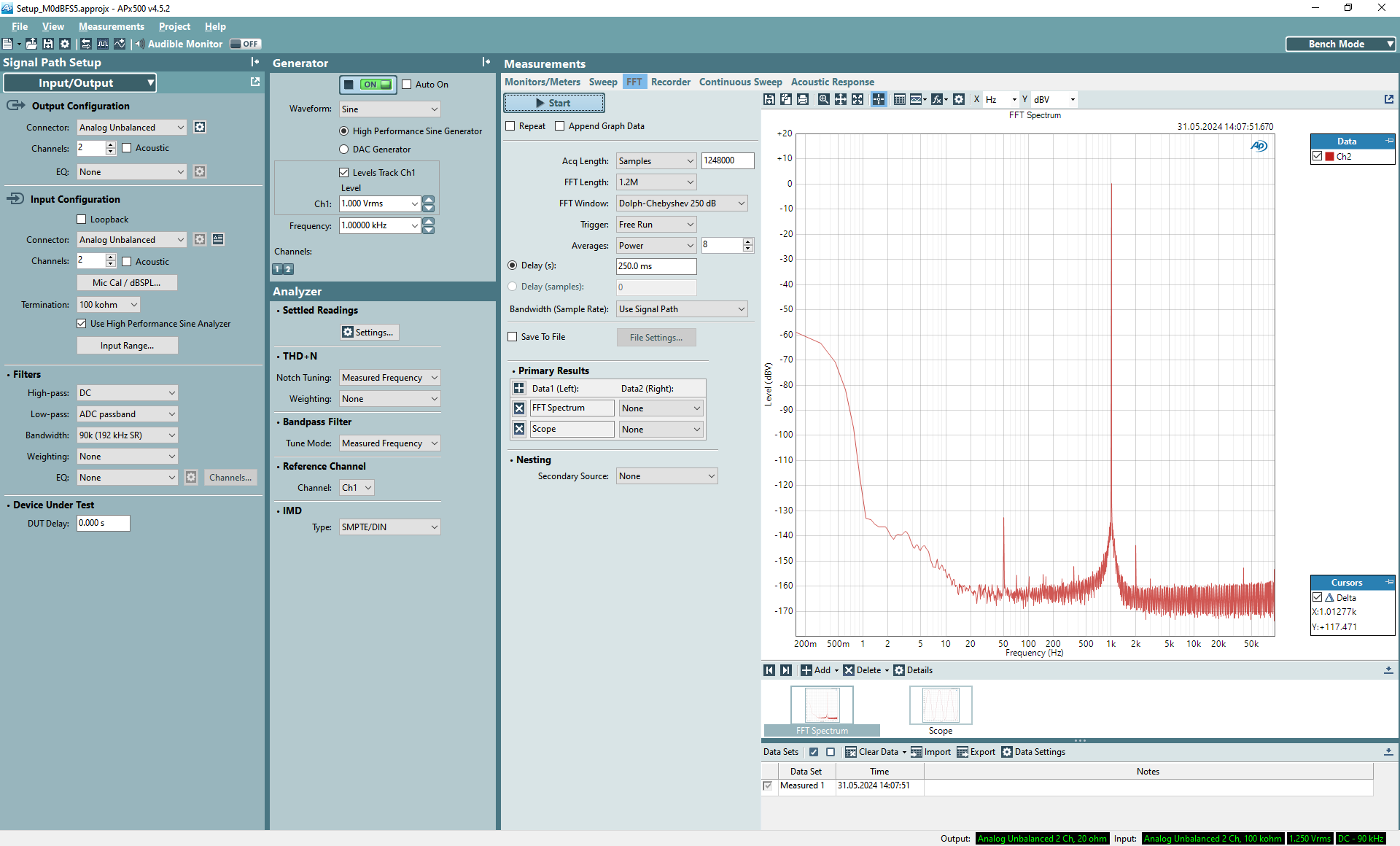
[picture p42: figure]

## Slide 3

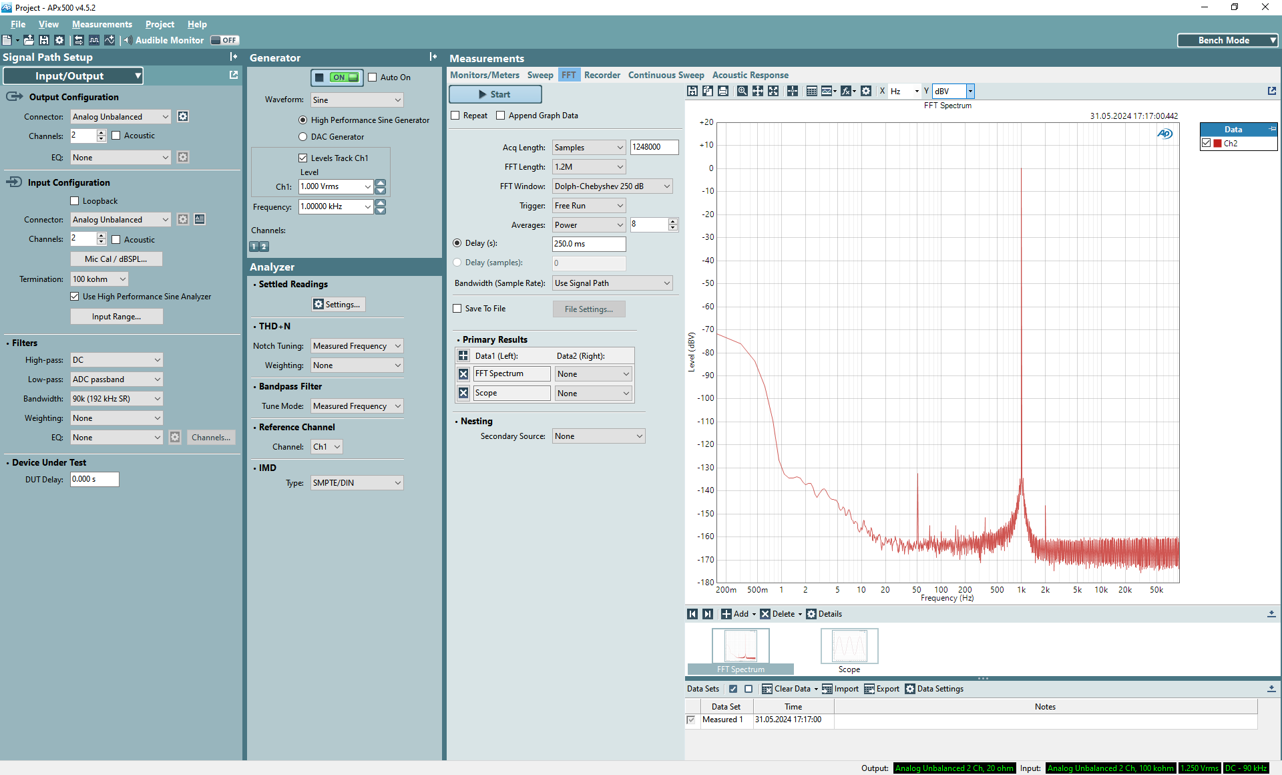
[picture p43: figure]

## Slide 4

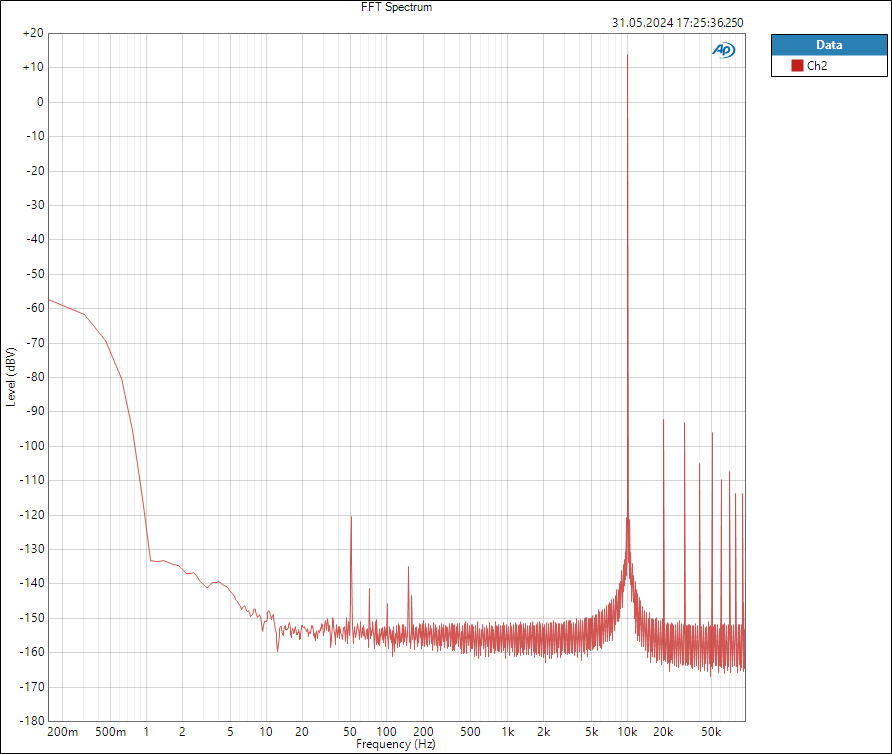
[picture p44: figure]

## INPUT

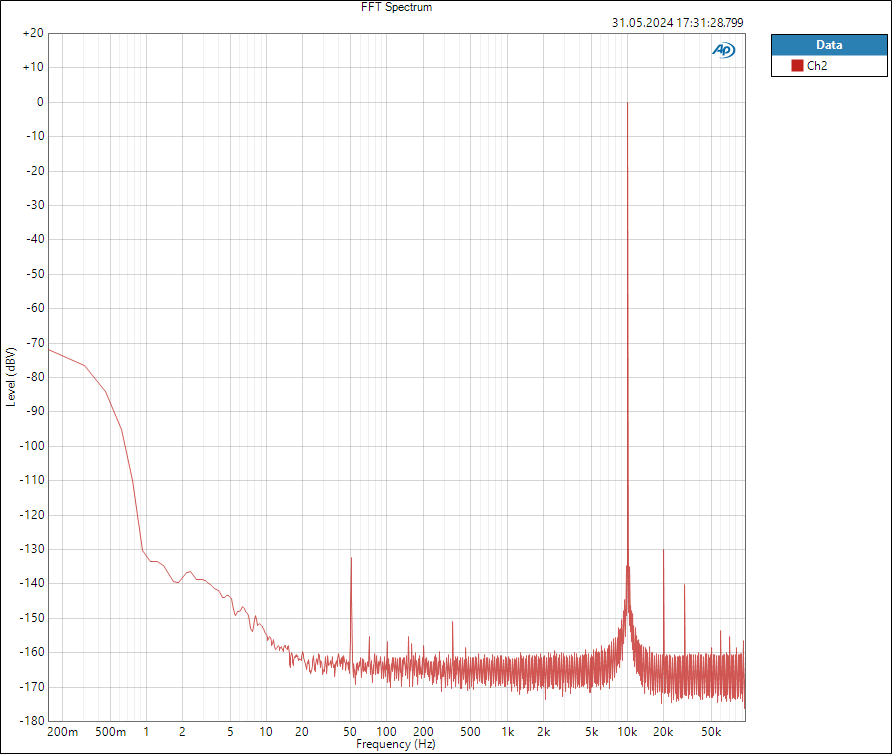
[picture p45: figure]
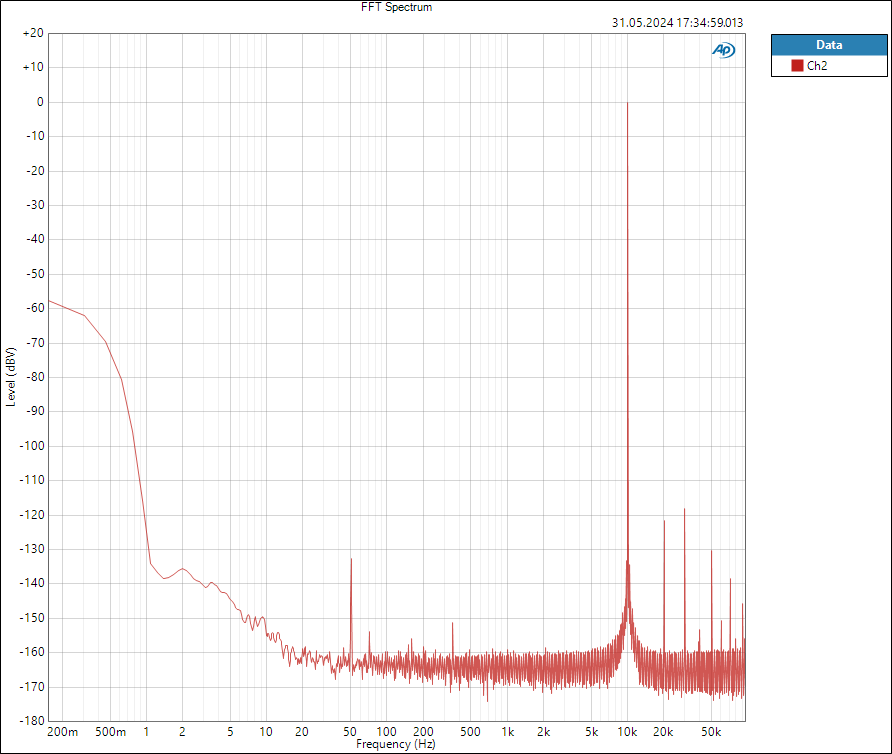
[picture p46: figure]

OUT
