rjiuzzol/True8Digit/AD4630-24/dataset/ENOB/enob_fig.png

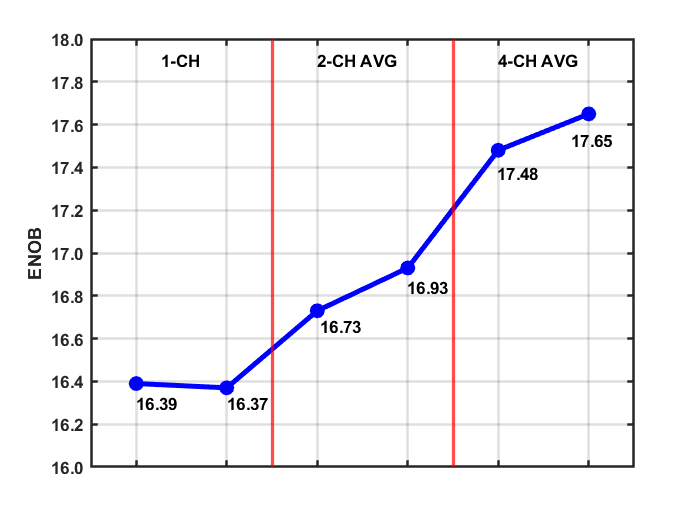
AD4630-24/dataset/ENOB/enob_fig.png
