rjiuzzol/True8Digit/COPA/dataset_1/Board_1_GAIN_14062024.png

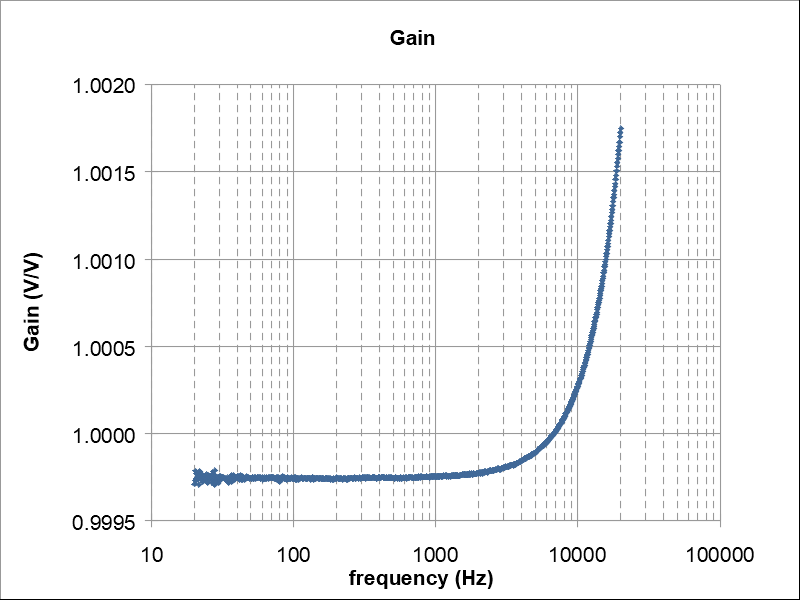
COPA/dataset_1/Board_1_GAIN_14062024.png
