rjiuzzol/True8Digit/COPA/dataset_1/Board_1_GAIN_PH_19062024_FS.png

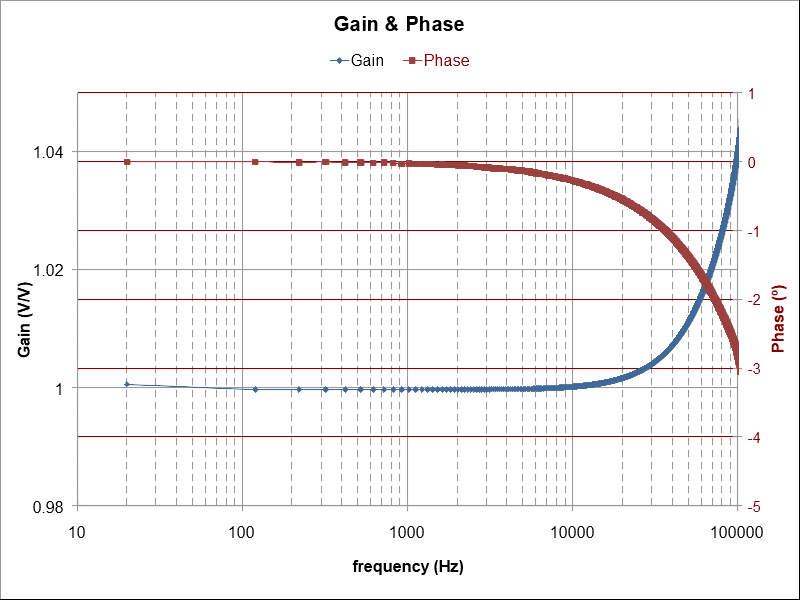
COPA/dataset_1/Board_1_GAIN_PH_19062024_FS.png
