rjiuzzol/True8Digit/COPA/dataset_1/Board_1_THD_13062024.png

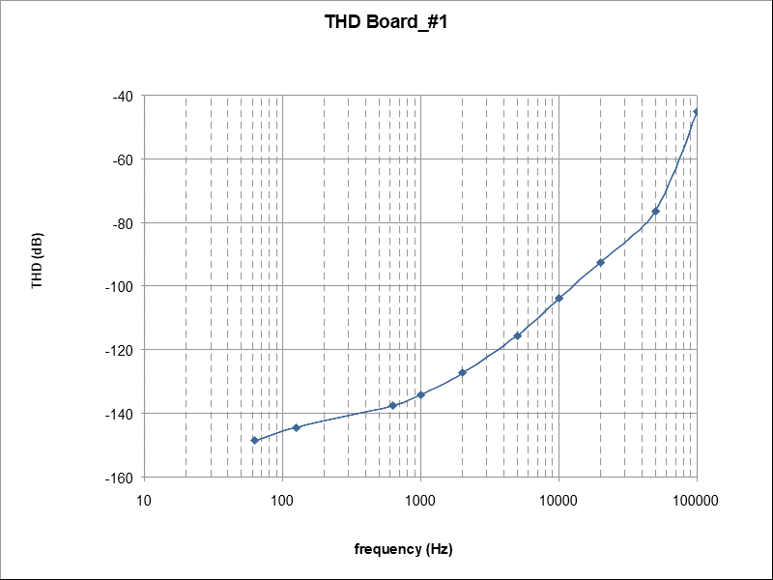
COPA/dataset_1/Board_1_THD_13062024.png
