rjiuzzol/True8Digit/COPA/dataset_1/Board_1_THD_vs_input_amplitude.png

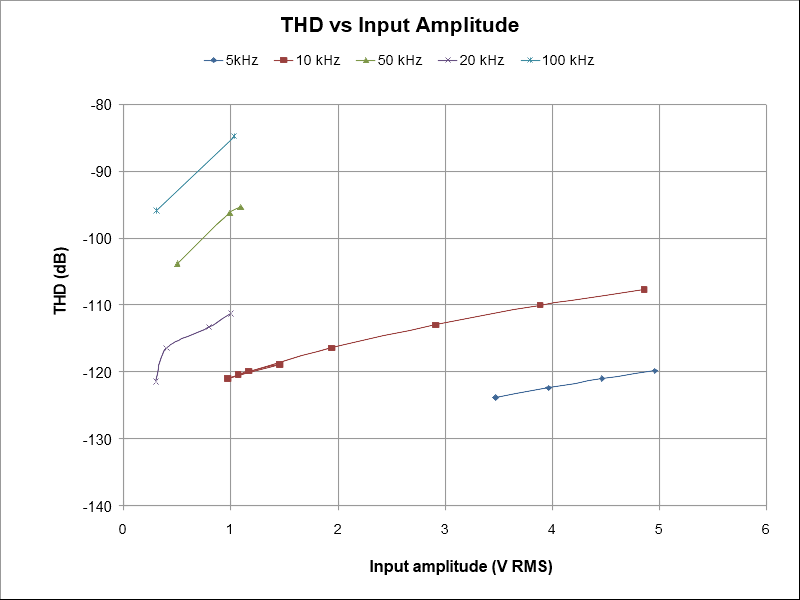
COPA/dataset_1/Board_1_THD_vs_input_amplitude.png
