rjiuzzol/True8Digit/COPA/dataset_1/Board_1_VNOISE.png

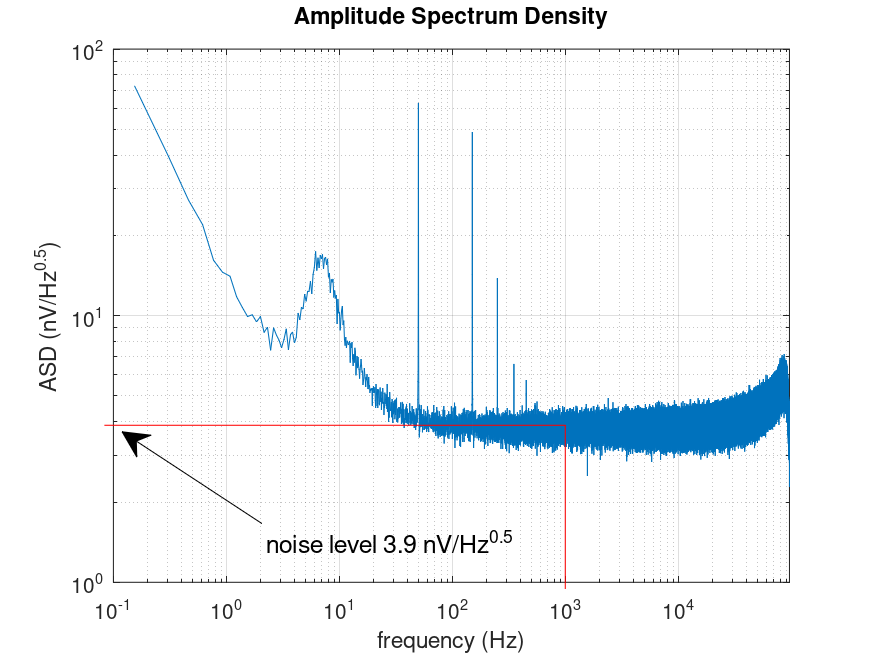
COPA/dataset_1/Board_1_VNOISE.png
