rjiuzzol/True8Digit/COPA/dataset_1/Board_1_ZI_from20Hz_to_20kHz.png

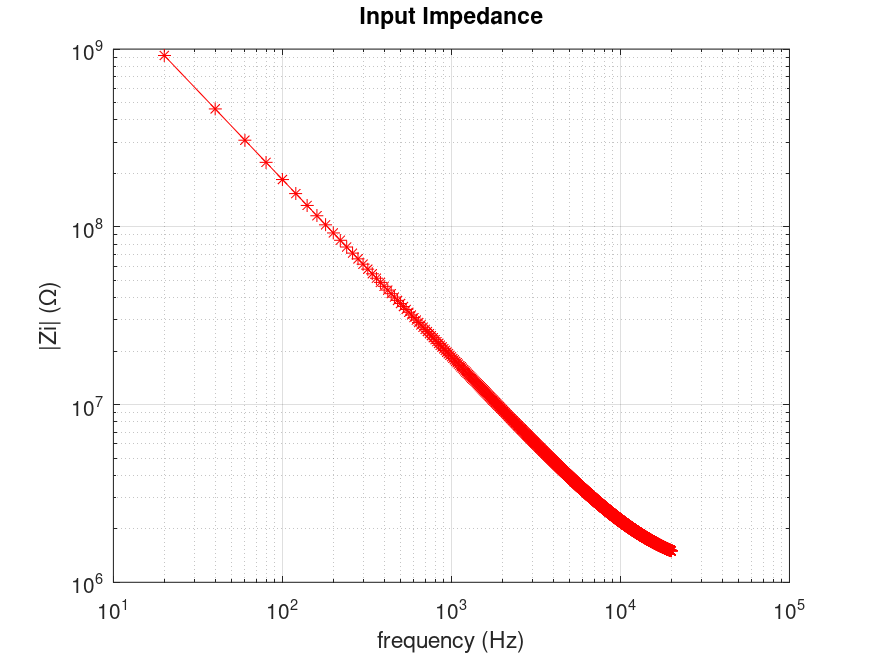
COPA/dataset_1/Board_1_ZI_from20Hz_to_20kHz.png
