rjiuzzol/True8Digit/COPA/dataset_1/Board_2_Gain_Phaase_10062024.png

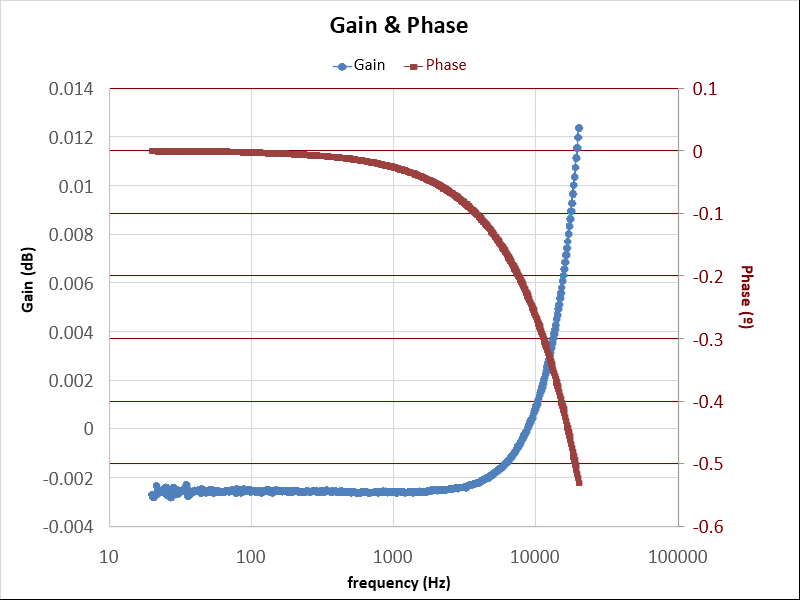
COPA/dataset_1/Board_2_Gain_Phaase_10062024.png
