rjiuzzol/True8Digit/COPA/dataset_1/Board_2_THD_10062024.png

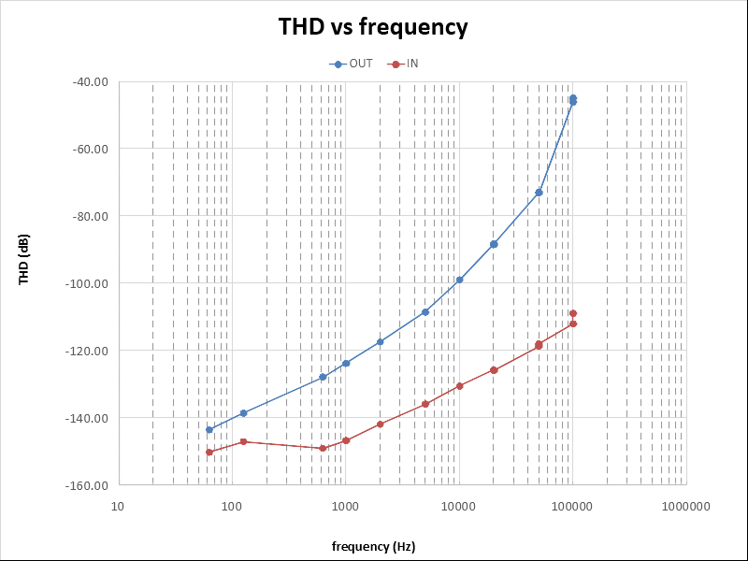
COPA/dataset_1/Board_2_THD_10062024.png
