rjiuzzol/True8Digit/COPA/dataset_1/Results_20240613_THD/Board_1/board_1_Spectrum_IN_7.071_62.5_BW90kHz_20240613.png

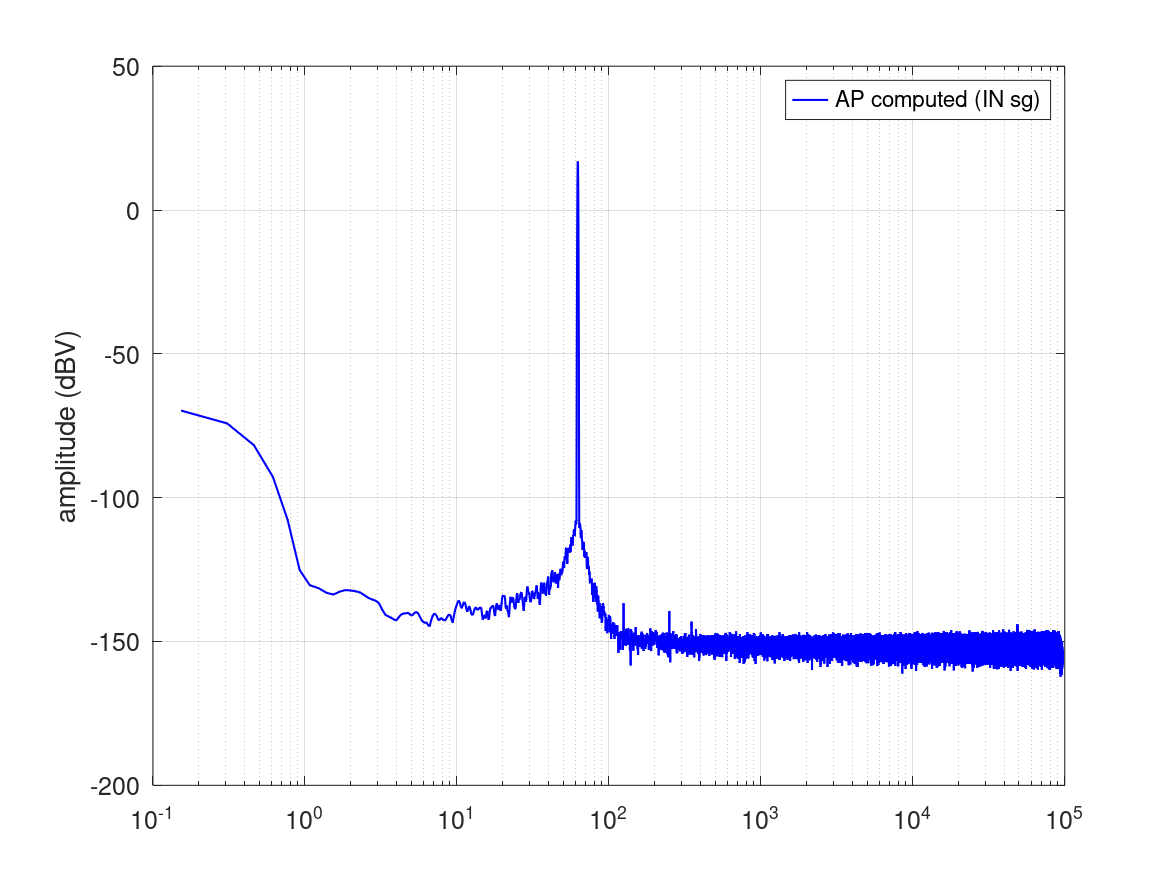
COPA/dataset_1/Results_20240613_THD/Board_1/board_1_Spectrum_IN_7.071_62.5_BW90kHz_20240613.png
