rjiuzzol/True8Digit/COPA/dataset_1/THD_Comparison.png

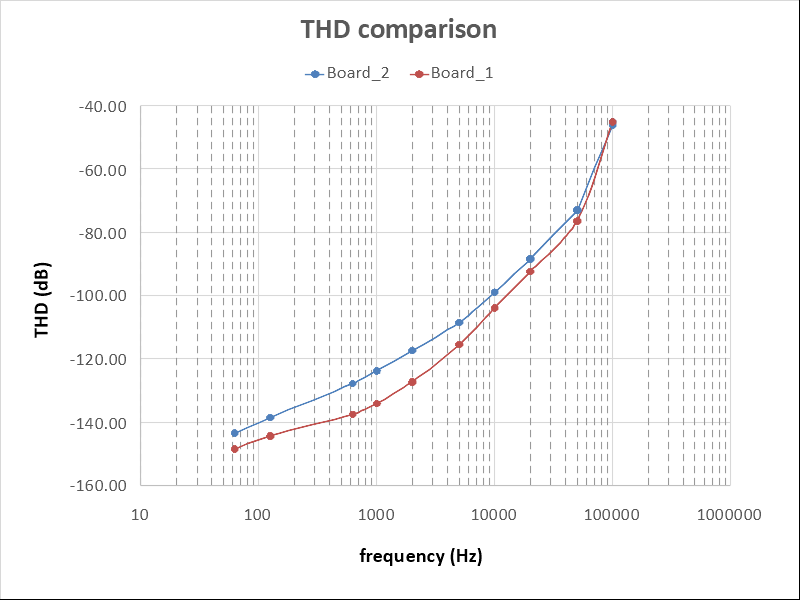
COPA/dataset_1/THD_Comparison.png
