rjiuzzol/True8Digit/Timing_Platform/dataset/jitter_delay/LMK04821Timing/Jitter/LMK04821 - TIE Histogram (Meas 4).png

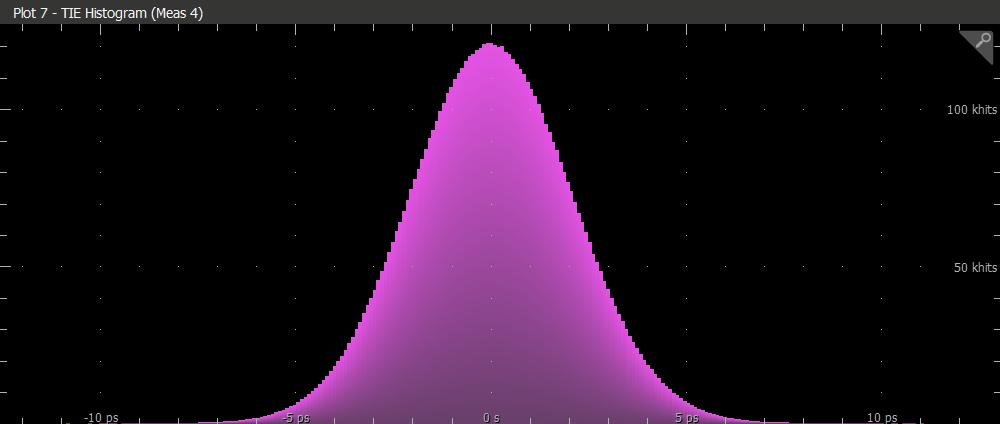
Timing_Platform/dataset/jitter_delay/LMK04821Timing/Jitter/LMK04821 - TIE Histogram (Meas 4).png
