rjiuzzol/True8Digit/Timing_Platform/dataset/jitter_delay/LMK04821Timing/Jitter/Tek000.png

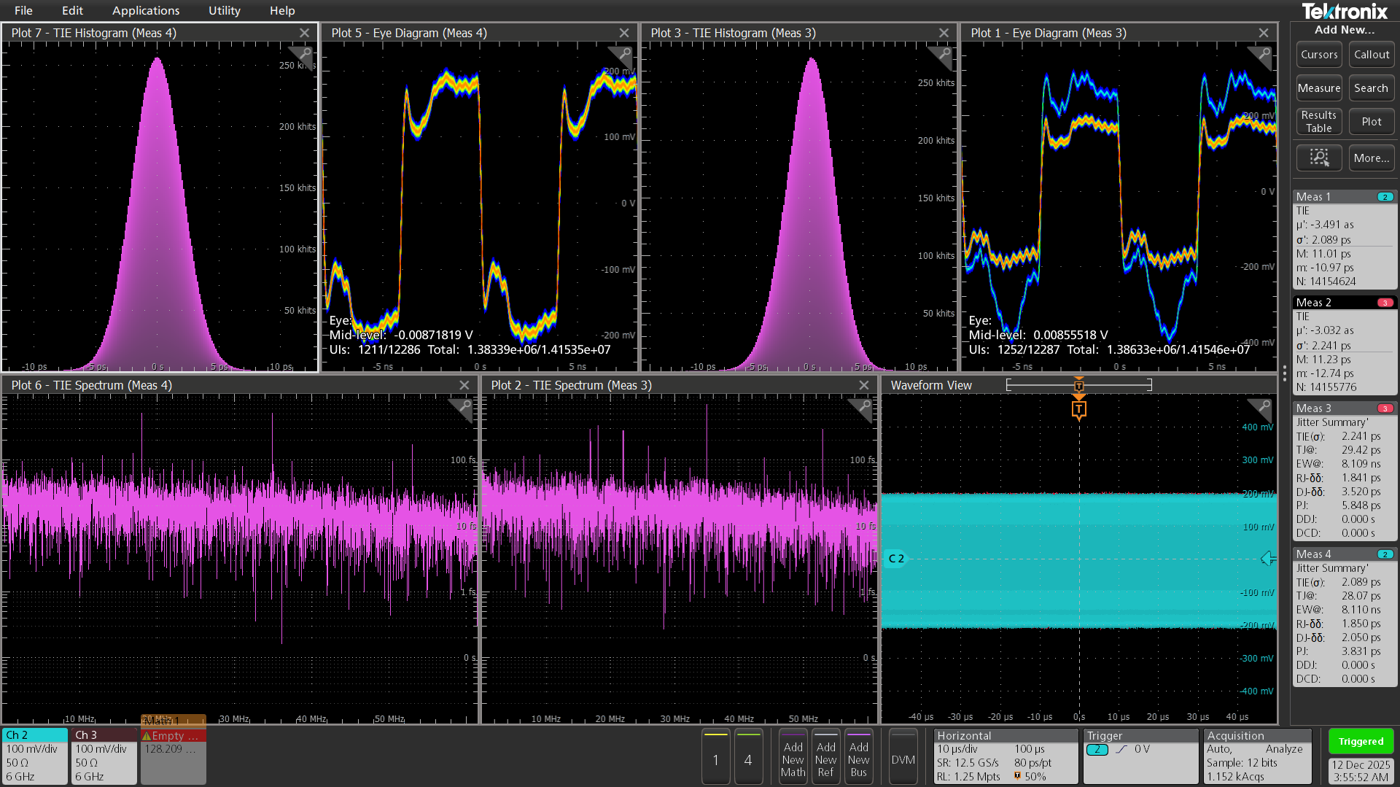
Timing_Platform/dataset/jitter_delay/LMK04821Timing/Jitter/Tek000.png
