rjiuzzol/True8Digit/Timing_Platform/dataset/jitter_delay/TIEVM/TI_LMK05318BEVM-100MHz-20240913.png

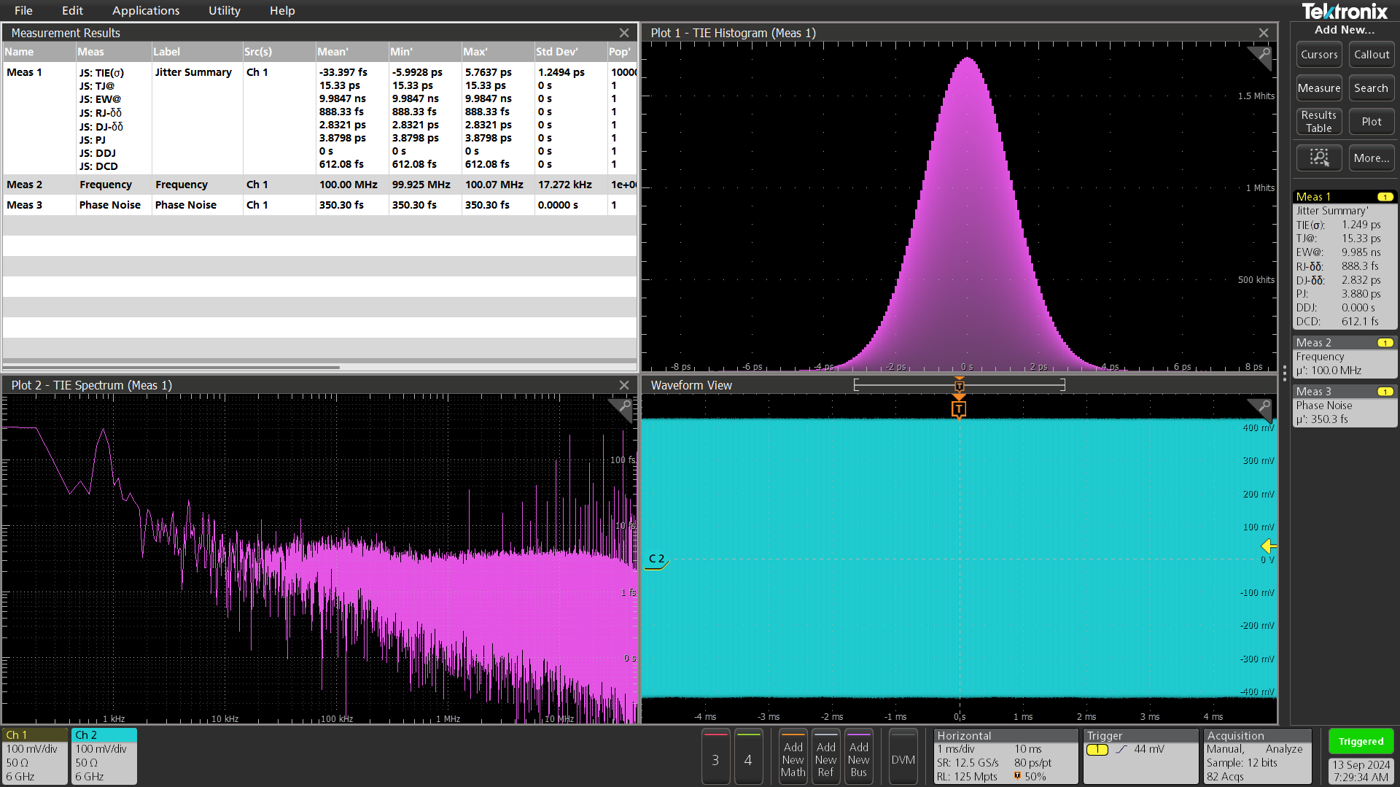
Timing_Platform/dataset/jitter_delay/TIEVM/TI_LMK05318BEVM-100MHz-20240913.png
