rjiuzzol/True8Digit/AD4630-24/Report/AD4630_Test_Report_v1_0.pdf

# Report on AD4630-24 EVAL Boards characterization

# Ricardo Iuzzolino¹ and Luis Palafox²

1

# Instituto Nacional de Tecnología Inductrial (INTI) - Argentina 2Physikalisch-Technische Bundesanstalt (PTB) - Germany

# August 2025

## Abstract

This report enumerates different tests made at PTB for two AD4630-24 evaluation boards, one belongs to Left Right and the second to INTI. The main characterization was in terms of the Total Harmonic Distortion (THD) at different input amplitudes, then the results were compared with the specifications on the ADC datasheet. Both boards were synchronized using the same 100 MHz clock signal, allowing averaging on time-domain -channels parallel operation and averaging- and in the frequency domain -Fourier transform averaging-. Also, clock spurs frequencies were detected.

# 1 Introduction

Two AD4630-24 evaluation boards [1] were evaluated in terms of total harmonic distortion and parallel operation and averaging. The use of high resolution ADC is increasing, the main goal of the True8Digit project is to show the possibility to go up to 8-1/2 digit exiting signal averaging and ADC parallel operation.

# 2 Total Harmonic Distortion Test and Analysis

# 2.1 Measurement Setup

The measuring setup is shown in figure 1, the ultra low distortion source, the APx555 was used to excite the ADC input. Two AD4630-24 evaluation boards were connected in parallel using a custom connection box, as can be seen in the center of figure 1). In order to synchronize both ADCs, a master/slave configuration was set, the main clock of RA EVAL boards (right-top of fig.1) of frequency equal to 100 MHz was connected to RI (right-bottom of fig.1) board as is depicted in the figure by the blue 3.5 mm cable.

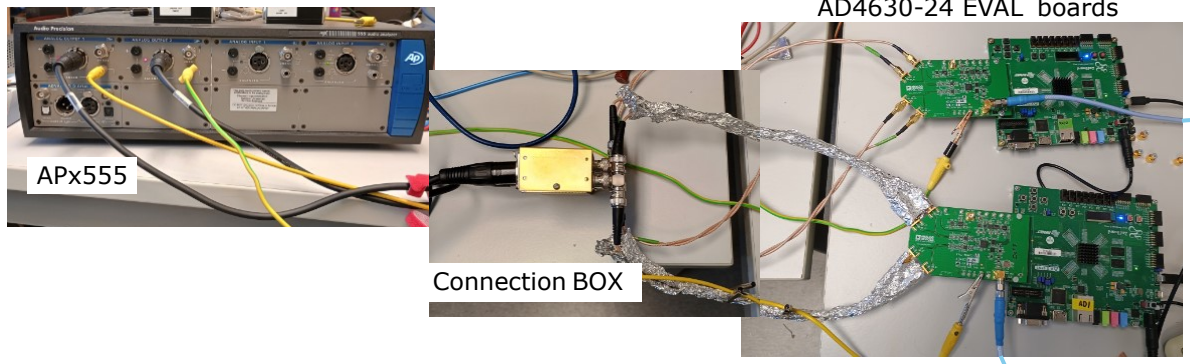
[picture p79: figure]
APx555; Connection BOX

# AD4630-24 EVAL boards

## Figure 1: Measurement setup. The APx55 deliver a low distorted signal, a parallel connec-

tion was possible using a connection box (middle) and the two evaluation boards running with the same clock, RA board at the right-top as master and the RI board right-bottom as slave.

1

# Report on AD4630-24 EVAL Boards characterization

# 2.2 Two board analysis

The first study was to compute the Total Harmonic Distortion of the two boards versus input signal amplitudes and frequency, taken into taken into account the first fifth harmonics as the ration between the squared root of the square sum of the harmonic to the RMS voltage of the fundamental frequency as indicated by equation 1.

## THD =

qP5
j=2 V

2
RMSj

VRMS0

(1)

The RMS voltages were obtained in the frequency domain using a windowed FFT, window applied to the ADC data was a 7-term Blackman-Harris [2].
Amplitudes range were: −10 dBFS, −6 dBFS, −3 dBFS and −1 dBFS, at frequencies from 62.5 Hz up to 200 kHz. The results are shown in Table 1 for RI board and plotted in figure 2a for RA board and in figure 2b for RI board.
THD versus input amplitudes and frequencies for the two boards under test are depicted in figure 2

# and table 1

## Figure 2: Board RA and RI - THD vs Input signal amplitude and frequency

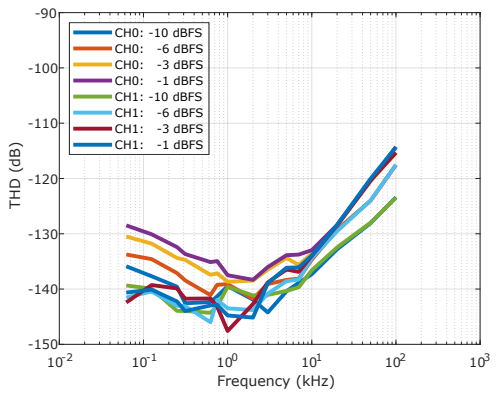
[picture p80: figure]
Frequency (kHz); THD (dB); CH0: -10 dBFS; -6 dBFS; -3 dBFS; -1 dBFS; CH1: -10 dBFS

## (a) Board RA - THD

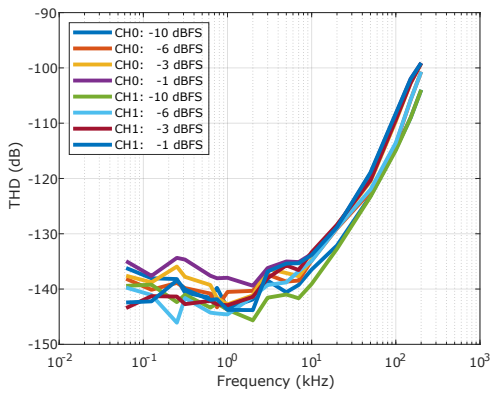
[picture p81: figure]
Frequency (kHz); THD (dB); CH0: -10 dBFS; -6 dBFS; -3 dBFS; -1 dBFS; CH1: -10 dBFS

## (b) Board RI - THD

## Table 1: Board RI - Results

Freq. | Fund. | THD | SINAD | ENOB
(Hz) | (dBFS) | (dB) | (dB)
62.5 | -10.3274 | -136.1918 | 90.7905 | 16.50
124.9 | -10.3274 | -138.0479 | 90.7806 | 16.50
250.1 | -10.3274 | -138.1932 | 90.7350 | 16.50
312.6 | -10.3274 | -140.6363 | 90.7447 | 16.50
625.1 | -10.3275 | -141.5769 | 90.7245 | 16.49
750.1 | -10.3275 | -139.7872 | 90.7232 | 16.49
1000.2 | -10.3279 | -143.4589 | 90.9492 | 16.53
2000.6 | -10.3281 | -141.8888 | 90.9278 | 16.53
2999.8 | -10.3282 | -138.4812 | 89.8963 | 16.36
5000.1 | -10.3288 | -140.5748 | 89.1245 | 16.23
7001.6 | -10.3297 | -139.2610 | 89.5473 | 16.30
10001.4 | -10.3315 | -136.4773 | 87.7685 | 16.00
20005.9 | -10.3425 | -132.1135 | 83.8247 | 15.35
49984.7 | -10.4180 | -123.1780 | 67.9737 | 12.73
100023.7 | -10.6786 | -114.6712 | 63.8714 | 12.09
150139.1 | -11.0878 | -109.0131 | 56.9281 | 11.01
200342.4 | -11.6204 | -103.9734 | 54.9299 | 10.76

## (a) Channel 0 - Input amplitude: −10 dBFS

Freq. | Fund. | THD | SINAD | ENOB
(Hz) | (dBFS) | (dB) | (dB)
62.5 | -10.3248 | -139.4231 | 90.5206 | 16.46
124.9 | -10.3248 | -139.2064 | 90.4800 | 16.45
250.1 | -10.3248 | -142.3653 | 90.4757 | 16.45
312.6 | -10.3249 | -141.0258 | 90.4757 | 16.45
625.1 | -10.3249 | -143.3590 | 90.2848 | 16.42
750.1 | -10.3249 | -142.5945 | 90.3559 | 16.43
1000.2 | -10.3253 | -143.7360 | 91.0859 | 16.55
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
100023.7 | -10.6782 | -114.7945 | 63.8759 | 12.09
150139.1 | -11.0878 | -109.0131 | 56.9281 | 11.01
200342.4 | -11.6204 | -103.9734 | 54.9299 | 10.76

## (b) Board RI Channel averaging - Input amplitude: −10 dBFS

## Figure 3: Boards Channel averaging - THD vs Input signal amplitude and frequency

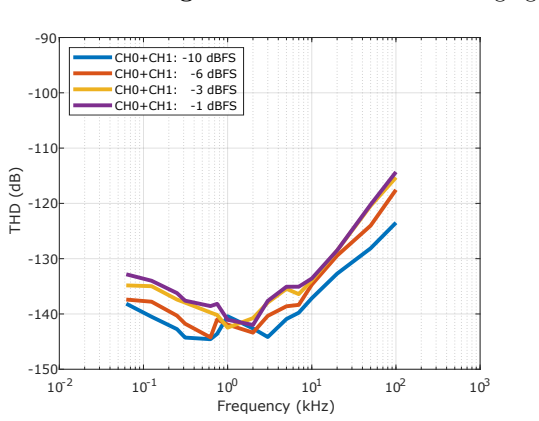
[picture p82: figure]
Frequency (kHz); THD (dB); CH0+CH1: -10 dBFS; -6 dBFS; -3 dBFS

## CH0+CH1: -1 dBFS (a) Board RA - THD - Chan-

## nels averaging - Dataset no. 2

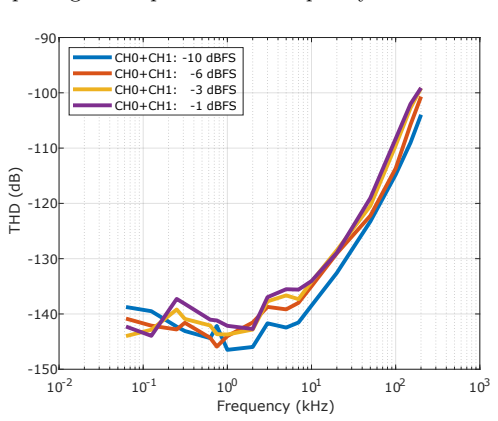
[picture p83: figure]
Frequency (kHz); THD (dB); CH0+CH1: -10 dBFS; -6 dBFS; -3 dBFS

## CH0+CH1: -1 dBFS (b) Board RI - THD - Chan-

## nels averaging - Dataset no. 2

# 2.4 Channels and FFT averaging

Total harmonic distortion when averaging the ADC two channels.

## Table 3: Channel and FFT averaging on Boards - Results

Freq. | Fund. | THD | SINAD | ENOB
(Hz) | (dBFS) | (dB) | (dB)
62.5 | -10.3275 | -138.2632 | 99.1539 | 17.89
124.9 | -10.3275 | -139.6522 | 99.1128 | 17.89
250.1 | -10.3277 | -142.3525 | 98.9926 | 17.87
312.6 | -10.3277 | -145.9773 | 98.9723 | 17.86
625.1 | -10.3282 | -145.9010 | 98.9365 | 17.86
750.1 | -10.3284 | -144.1997 | 98.9760 | 17.86
1000.2 | -10.3290 | -140.4557 | 98.8244 | 17.84
2000.6 | -10.3329 | -145.2261 | 98.6656 | 17.81
3000.0 | -10.3392 | -143.3427 | 94.1246 | 17.06
5000.1 | -10.3595 | -141.7181 | 91.9007 | 16.69
7001.6 | -10.3899 | -140.7539 | 91.5995 | 16.65
10001.4 | -10.4536 | -137.7956 | 89.9175 | 16.38
20005.9 | -10.8121 | -132.8764 | 85.8722 | 15.77
49984.7 | -12.7588 | -127.9222 | 66.4410 | 12.86
100023.7 | -16.5567 | -123.7358 | 64.1636 | 13.12

## (a) Board RA CHs and FFT averaging - Input amplitude: −10 dBFS

Freq. | Fund. | THD | SINAD | ENOB
(Hz) | (dBFS) | (dB) | (dB)
62.5 | -10.3261 | -139.6545 | 94.8948 | 17.19
124.9 | -10.3261 | -139.5839 | 94.8881 | 17.19
250.1 | -10.3261 | -142.4242 | 94.8383 | 17.18
312.6 | -10.3262 | -143.3949 | 94.8201 | 17.17
625.1 | -10.3262 | -144.7155 | 94.7950 | 17.17
750.1 | -10.3262 | -143.3017 | 94.8185 | 17.17
1000.2 | -10.3266 | -144.9764 | 94.7257 | 17.16
2000.6 | -10.3268 | -144.0188 | 94.6504 | 17.15
3000.0 | -10.3269 | -141.0726 | 92.3156 | 16.76
5000.1 | -10.3275 | -140.8297 | 90.7702 | 16.50
7001.6 | -10.3284 | -141.5555 | 90.3169 | 16.43
10001.4 | -10.3302 | -138.0081 | 89.1645 | 16.24
20005.9 | -10.3413 | -132.2358 | 85.3480 | 15.60
49984.7 | -10.4182 | -123.3692 | 66.4914 | 12.48
100023.7 | -10.6782 | -114.8296 | 64.0761 | 12.13
150139.1 | -11.0894 | -108.9273 | 56.9282 | 11.01
200342.4 | -11.6229 | -103.9398 | 54.9302 | 10.76

## (b) Board RI CHs and FFT averaging - Input amplitude: −10 dBFS

## Figure 4: Boards Channel and FFT averaging - THD vs Input signal amplitude and frequency

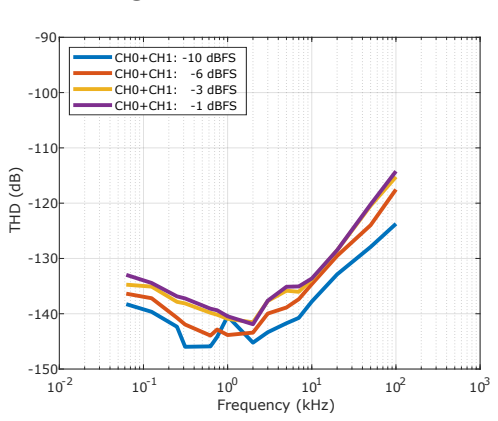
[picture p84: figure]
Frequency (kHz); THD (dB); CH0+CH1: -10 dBFS; -6 dBFS; -3 dBFS; -1 dBFS

## (a) Board RA-THD-Channels and FFT averaging

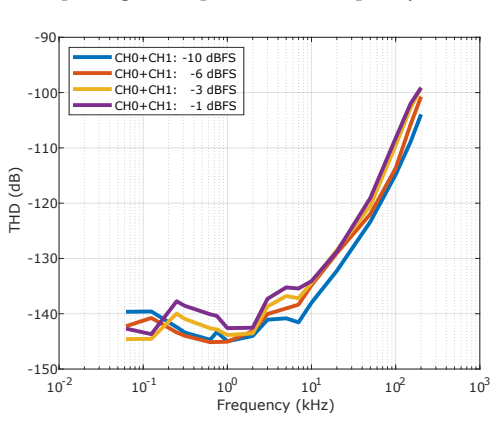
[picture p85: figure]
Frequency (kHz); THD (dB); CH0+CH1: -10 dBFS; -6 dBFS; -3 dBFS; -1 dBFS

## (b) Board RI-THD-Channels and FFT averaging

Signal spectrum when averaging the FFT results over all windows datasets (8 datasets in total)

## Table 4: Channel and FFT averaging on Boards - Results

Freq. | Fund. | THD | SINAD | ENOB
(Hz) | (dBFS) | (dB) | (dB)
62.5 | -10.3275 | -138.2632 | 99.1539 | 17.89
124.9 | -10.3275 | -139.6522 | 99.1128 | 17.89
250.1 | -10.3277 | -142.3525 | 98.9926 | 17.87
312.6 | -10.3277 | -145.9773 | 98.9723 | 17.86
625.1 | -10.3282 | -145.9010 | 98.9365 | 17.86
750.1 | -10.3284 | -144.1997 | 98.9760 | 17.86
1000.2 | -10.3290 | -140.4557 | 98.8244 | 17.84
2000.6 | -10.3329 | -145.2261 | 98.6656 | 17.81
3000.0 | -10.3392 | -143.3427 | 94.1246 | 17.06
5000.1 | -10.3595 | -141.7181 | 91.9007 | 16.69
7001.6 | -10.3899 | -140.7539 | 91.5995 | 16.65
10001.4 | -10.4536 | -137.7956 | 89.9175 | 16.38
20005.9 | -10.8121 | -132.8764 | 85.8722 | 15.77
49984.7 | -12.7588 | -127.9222 | 66.4410 | 12.86
100023.7 | -16.5567 | -123.7358 | 64.1636 | 13.12

## (a) Board RA CHs and FFT averaging - Input amplitude: −10 dBFS

Freq. | Fund. | THD | SINAD | ENOB
(Hz) | (dBFS) | (dB) | (dB)
62.5 | -10.3261 | -139.6545 | 94.8948 | 17.19
124.9 | -10.3261 | -139.5839 | 94.8881 | 17.19
250.1 | -10.3261 | -142.4242 | 94.8383 | 17.18
312.6 | -10.3262 | -143.3949 | 94.8201 | 17.17
625.1 | -10.3262 | -144.7155 | 94.7950 | 17.17
750.1 | -10.3262 | -143.3017 | 94.8185 | 17.17
1000.2 | -10.3266 | -144.9764 | 94.7257 | 17.16
2000.6 | -10.3268 | -144.0188 | 94.6504 | 17.15
3000.0 | -10.3269 | -141.0726 | 92.3156 | 16.76
5000.1 | -10.3275 | -140.8297 | 90.7702 | 16.50
7001.6 | -10.3284 | -141.5555 | 90.3169 | 16.43
10001.4 | -10.3302 | -138.0081 | 89.1645 | 16.24
20005.9 | -10.3413 | -132.2358 | 85.3480 | 15.60
49984.7 | -10.4182 | -123.3692 | 66.4914 | 12.48
100023.7 | -10.6782 | -114.8296 | 64.0761 | 12.13
150139.1 | -11.0894 | -108.9273 | 56.9282 | 11.01
200342.4 | -11.6229 | -103.9398 | 54.9302 | 10.76

## (b) Board RI CHs and FFT averaging - Input amplitude: −10 dBFS

## Figure 5: FFT averaging - Output signal spectrum for a -1 dBFS, 1 kHz input signal

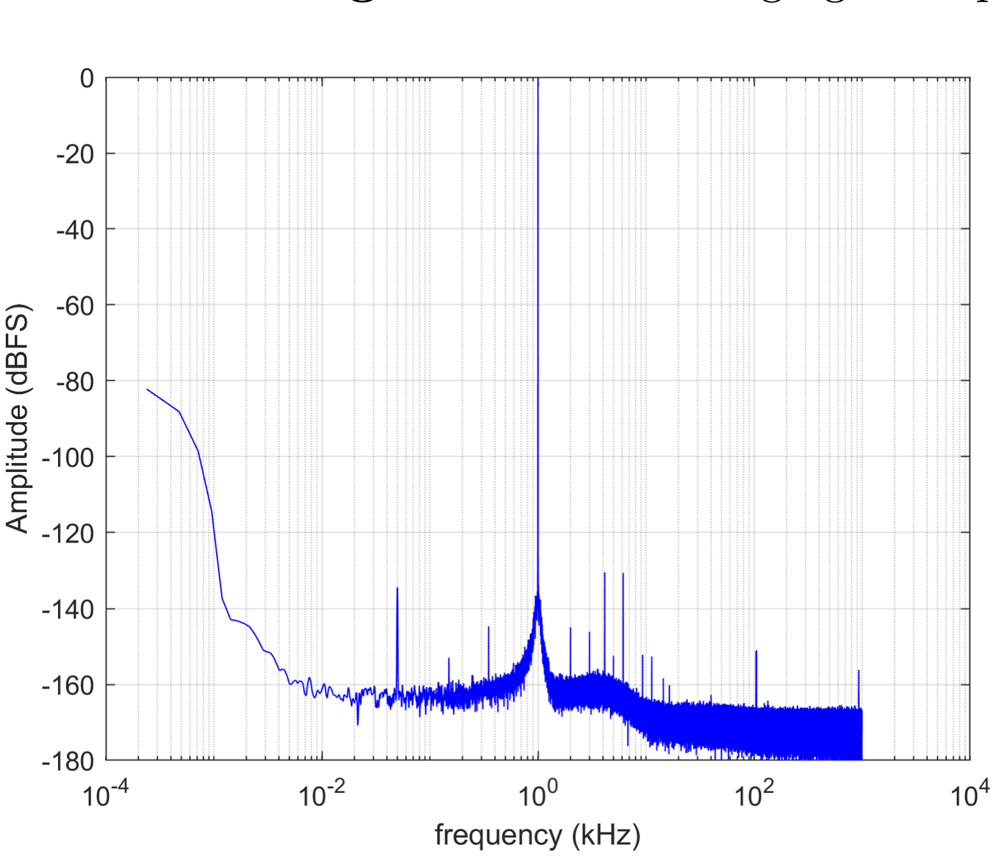
[picture p86: figure]
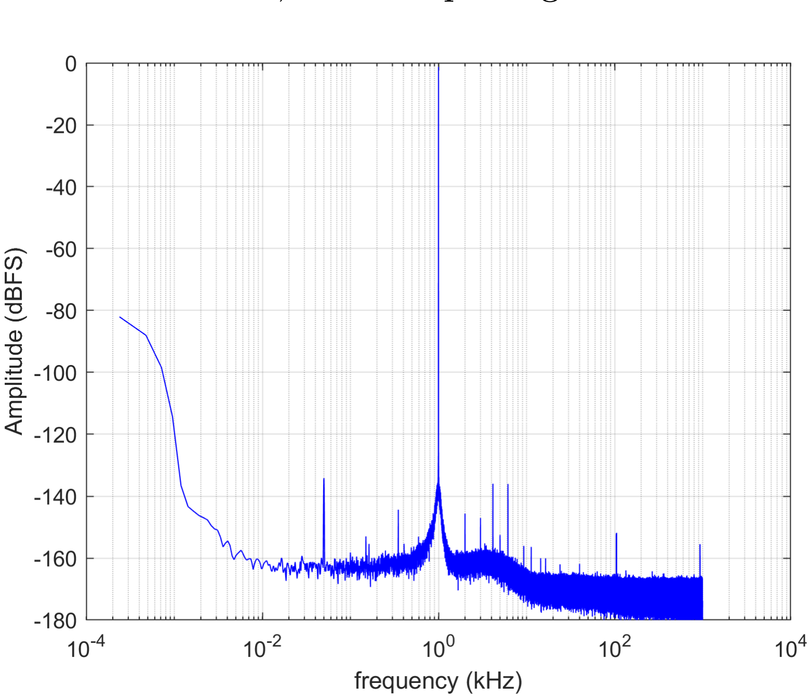
[picture p87: figure]

(a) Board RA-FFT averaging output spectrum | (b) Board RI-FFT averaging output spectrum

# 3 Parallel Operation - Two boards, four channels

Two AD4630-24 evaluation boards in parallel operation 4 channels post-processing time domain averaging.

# 3.1 Dynamic parameters results

In this subsection the formula and simple definition are explained.
THD: Total harmonic distortion. Ratio between the r.m.s. amplitude of harmonic contents to the

# fundamental r.m.s amplitude, according to:

# THD (dB) = 20 · log10

# qPN

j=1 A²
j
A0
- (2)

# SINAD: Signal-to.noise ratio plus distortion

# SINAD (dB) =

S
N
+ THD | (3)

# ENOB: Effective Number of Bits, considering input signal amplitude lower than FS

# ENOB =

# SINAD − 1.76 dB + Input level below FS

6.02 dB | (4)

## Table 5: 2 Boards 4 Channel in Parallel Dataset and FFT averaging - Results

Freq. | Fund. | THD | SINAD | ENOB
(Hz) | (dBFS) | (dB) | (dB)
62.5 | -10.3268 | -139.9553 | 98.6113 | 17.80
124.9 | -10.3268 | -140.5213 | 98.6159 | 17.80
250.1 | -10.3269 | -145.9094 | 98.5593 | 17.80
312.6 | -10.3269 | -147.1177 | 98.4753 | 17.78
625.1 | -10.3272 | -147.4747 | 98.4855 | 17.78
750.1 | -10.3273 | -146.3566 | 98.5421 | 17.79
1000.2 | -10.3278 | -144.5083 | 98.4263 | 17.77
2000.6 | -10.3298 | -145.6047 | 98.3400 | 17.76
2999.8 | -10.3331 | -143.8960 | 95.4755 | 17.28
5000.1 | -10.3435 | -142.5620 | 94.7991 | 17.17
7001.6 | -10.3591 | -141.6890 | 93.1492 | 16.90
10001.4 | -10.3917 | -137.9586 | 91.6424 | 16.66

## (a) 2 Boards 4-CHs Dataset averaging -Dataset no. 2 - Input amplitude: −10 dBFS

Freq. | Fund. | THD | SINAD | ENOB
(Hz) | (dBFS) | (dB) | (dB)
62.5 | -10.3268 | -140.2196 | 99.5188 | 17.95
124.9 | -10.3268 | -140.5708 | 99.5029 | 17.95
250.1 | -10.3269 | -144.8356 | 99.4375 | 17.94
312.6 | -10.3269 | -146.6421 | 99.4131 | 17.94
625.1 | -10.3272 | -148.0534 | 99.3732 | 17.93
750.1 | -10.3273 | -146.9779 | 99.4202 | 17.94
1000.2 | -10.3278 | -143.9858 | 99.3157 | 17.92
2000.6 | -10.3298 | -146.1256 | 99.1886 | 17.90
3000.0 | -10.3344 | -142.7917 | 95.9996 | 17.37
5000.1 | -10.3435 | -142.2183 | 94.2281 | 17.08
7001.6 | -10.3591 | -141.6884 | 94.1233 | 17.06
10001.4 | -10.3918 | -138.1884 | 92.0571 | 16.73

## (b) 2 Boards 4-CHs FFT averaging - Input amplitude: −10 dBFS

## Figure 6: THD for parallel boards operation and overall chan-

nels averaging in frequency range from 62.5 Hz to 10 kHz.

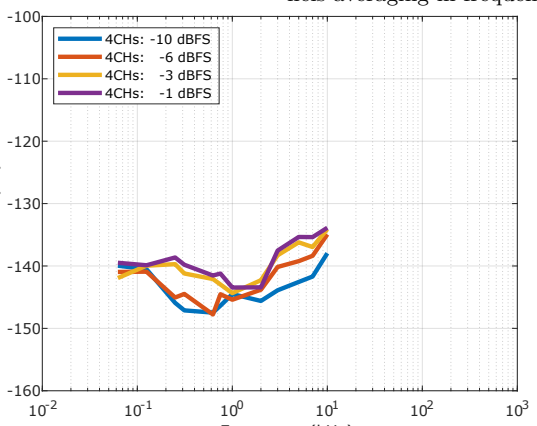
[picture p88: figure]
4CHs: -10 dBFS 4CHs: -6 dBFS 4CHs: -3 dBFS 4CHs: -1 dBFS

## Frequency (kHz)

### THD (dB)

## (a) Parallel channels operation and averaging - Data set time domain averaging

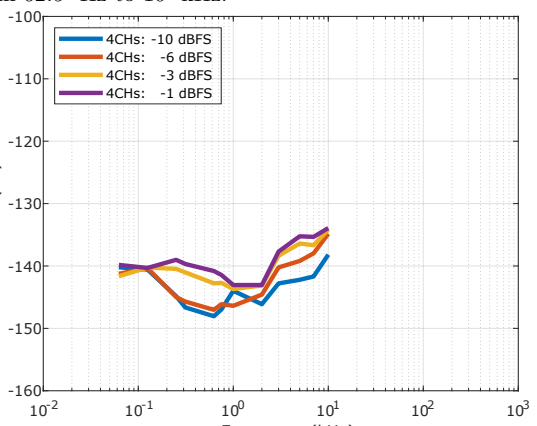
[picture p89: figure]
4CHs: -10 dBFS 4CHs: -6 dBFS 4CHs: -3 dBFS 4CHs: -1 dBFS

## Frequency (kHz)

### THD (dB)

## (b) Parallel channels operation and averaging - Time domain and FFT averaging

# 3.2 ENOB calculation and comparison

In order to improve the SNR (and potentially also other parameters) by parallel ADC operation, multiple ADCs are followed by post processing to digital summation of their outputs. Using this simple technique, the perfectly correlated signals in the output sum result will increase by a factor N, while perfectly uncorrelated signals will only increase by a factor of N/2.
In the case of adding the input voltage signal from four different ADC, the output common signal, VT OT after post processing results in the linear summation of the input voltage signal, VADCj

# , from each ADC, Vin, plus the root square sum of the noise voltages, eNj

, as [3],

VT OT =

X

M

j=1

VADCj +

# vuut

Xm

j=1

e

2
Nj
, | (5)

where M is the total number of ADC (4 in this case).
Since SNR(dB) = 6.02 N + 1.76, where N is the number of bits, the above assumption gives the

# increase in effective resolution:

N + ∆N =

1
6.02

## - (SNR(dB) − 1.76 + 6.02 dB) =

# SNR(dB

6.02

−

1.76

6.02
+

6.02 dB
6.02

= N + 1 (6)

The Effective Number of Bits was calculated for measurements setup and conditions. Then, it is compared in this section. The comparison is made at reference frequency of 1 kHz. Table shows the results and comparison.

Table 6: Parallel Operation - Results - Last columns show the ∆N when averaging 4-CH from 1-CH

Board | Meas Type | Ch | Freq (Hz) | Fund (dBFS) | SINAD (dB) | ENOB | ∆N
RI+RA RI+RA RI RI RI RI | 2B-4CH-FFT AVG 2B-4CH-DS AVG 1B CH+FFT_AVG 1B CH_AVG DS Single channel Single channel | 4 4 2 2 0 1 | 1000.2 | -10.32 | 99.31 98.42 94.72 93.80 90.94 91.08 | 17.92 17.77 17.16 17.01 16.53 16.55 | 1.37

## (a) Results for input signal amplitude -10 dBFS and frequency 1 kHz. The ∆N = 1.37 bits

Ch | Freq (Hz) | Fund (dBFS) | SINAD (dB) | ENOB | ∆N
4 4 2 2 0 1 | 1000.2 | -6.17 | 102.89 102.06 98.39 97.50 94.85 94.98 | 17.83 17.69 17.08 16.93 16.49 16.51 | 1.31

## (b) Results for input signal amplitude -6 dBFS and frequency 1 kHz. The ∆N = 1.31 bits

Ch | Freq (Hz) | Fund (dBFS) | SINAD (dB) | ENOB | ∆N
4 4 2 2 0 1 | 1000.2 | -3.18 | 105.23 104.41 100.84 100.00 97.57 97.70 | 17.72 17.58 16.99 16.85 16.45 16.47 | 1.25

## (c) Results for input signal amplitude -3 dBFS and frequency 1 kHz. The ∆N = 1.25 bits

Ch | Freq (Hz) | Fund (dBFS) | SINAD (dB) | ENOB | ∆N
4 4 2 2 0 1 | 1000.2 | -1.17 | 106.84 105.84 102.49 101.29 99.16 99.27 | 17.65 17.48 16.93 16.73 16.37 16.39 | 1.26

## (d) Results for input signal amplitude -1 dBFS and frequency 1 kHz. The ∆N = 1.26 bits

Figure 7: Parallel channels operation and averaging - Effective Number of Bits for input amplitude -1.17 dBFS.

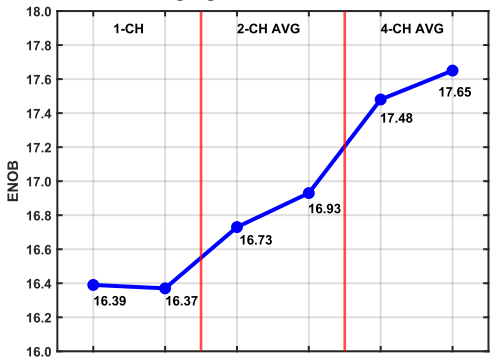
[picture p90: figure]

# 4 Board RI bandwidth extension

The EVAL Board comes with different possibles front-end configurations, see ADI web page, the default is a fully differential amplifier with G=1 and a low pass filter having a cut-off frequency around f−3 dB = 54 kHz.

Figure 8: Fully differential amplifier circuit at the EVAL Board.

## R18-C118 and R24-C119 conform a LPF withf−3 dB = 54 kHz

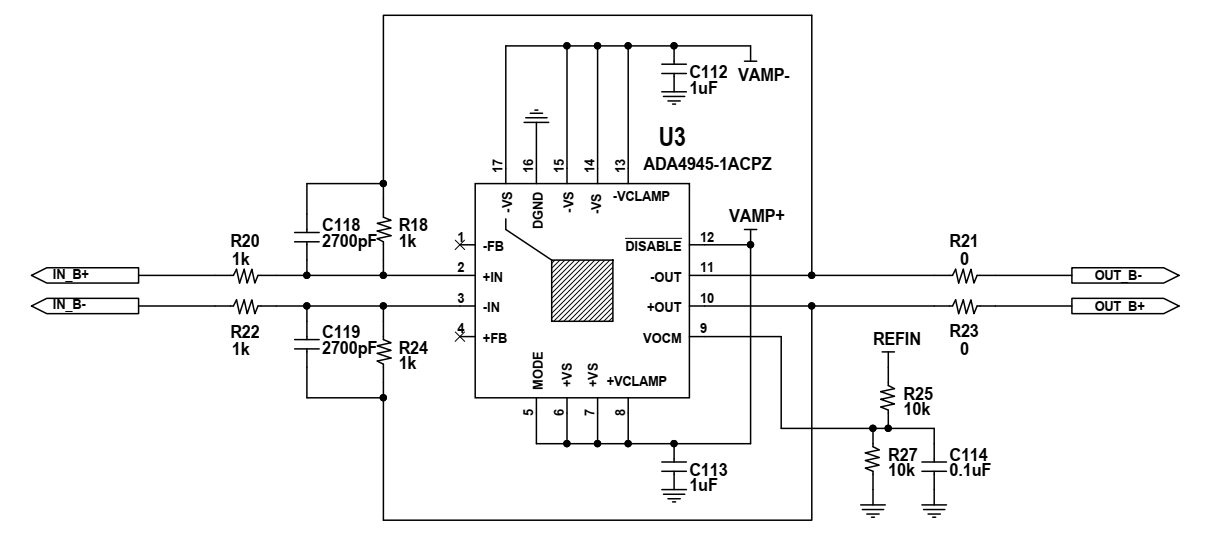
[picture p91: figure]

# Input LPF is

## Figure 9: Input LPF with a f−3 dB = 1.59 MHz

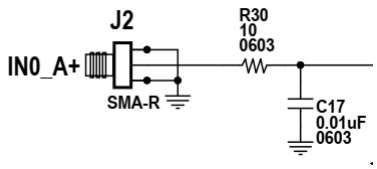
[picture p92: figure]

# 5 Sampling clock spurs frequency

Clock spurs appeared in the spectrum [4], which are mainly due to jitter at the FPGA of the evaluation

# board. As depicted in figure 10 there are two images at:

f =

(
f1 = fIN + (fspur − fCLK)

f2 = fIN − (fspur − fCLK)

where fIN is the input signal frequency, fspur is the spur frequency and fCLK is the sampling clock. For an input signal frequency of 10 kHz, a sampling clock of 2 MHz, the spurs are at f = 1.994766 MHz, which gives a ∆f equal to 5232 Hz.

## Figure 10: Clock Spurs

# References

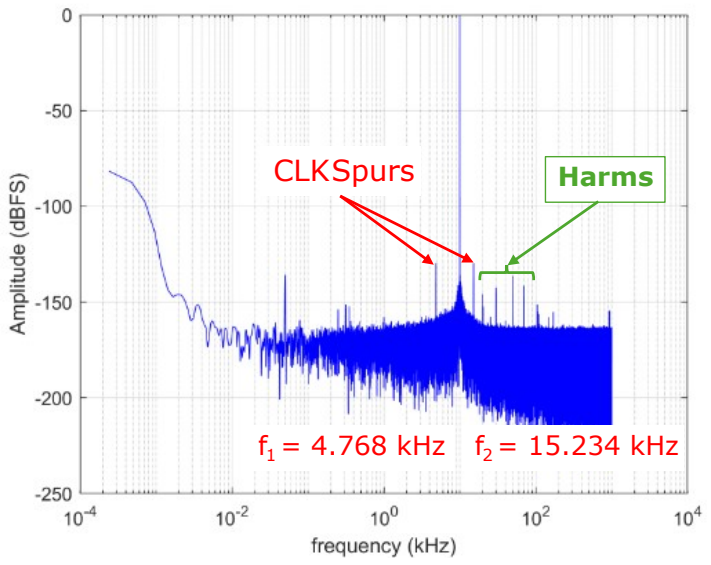
[picture p93: figure]
CLKSpurs; Harms; f1 = 4.768 kHz; f2 = 15.234 kHz

[1] AD4630-24 SAR ADC Evaluation Board, Analog Devices inc.
[2] F. J. Harris, ”On the use of windows for harmonic analysis with the discrete Fourier transform,” in Proceedings of the IEEE, vol. 66, no. 1, pp. 51-83, Jan. 1978.
[3] Rob Reeder, Mark Looney and Jim Hand, “Pushing the State of the Art with Multichannel A/D Converters”, Analog Dialogue, Vol.39, No. 05, May 2005.

# [4] Thomas Neu, “Impact of sampling-clock spurs on ADC performance “, Analog Applications

Journal, Texas Instruments Incorporated, 3Q 2009.
