rjiuzzol/True8Digit/COPA/dataset_1/COPA_Test_Summary_part01.xlsx

Sheet: 20241007
 |  |  |  |  | INPUT |  | OUTPUT
frequency (Hz) | Harmonic # | Amplitude (dB) | Amplitude (dBc) | Input Amplitude (dB) | Amplitude RMS (V) | THD (dB) | Amplitude RMS rel. (V) | THD (dB)
1000.153846 | 1 | 16.79 | 0.0 | 16.793 | 6.913 |  | 1.000
2000.153846 | 1.999846178 | -112.96 | -129.747 | -135.649 | 1.650342751e-07 |  | 3.255646929e-07
3000.307692 | 2.999846178 | -107.56 | -124.350 | -133.059 | 2.22365957e-07 |  | 6.060383401e-07
4000.461538 | 3.999846178 | -130.76 | -147.554 | -141.075 | 8.836378291e-08 | -147.118 | 4.191008581e-08 | -123.105042
5000.615385 | 4.999846179 | -122.19 | -138.98 | -147.474 | 4.229529905e-08 |  | 1.124713738e-07
6002 | 6.001076758 | -148.85 | -165.646 | -151.101 | 2.785946999e-08 |  | 5.220653264e-09
7000.769231 | 6.999692356 | -131.60 | -148.387 | -145.177 | 5.51019667e-08 |  | 3.807636225e-08
8001.076923 | 7.999846179 | -148.81 | -165.599 | -147.31 | 4.308112146e-08 |  | 5.24842445e-09
9002.615385 | 9.001230582 | -149.26 | -166.052 | -150.716 | 2.912009919e-08 |  | 4.982123054e-09
10001.53846 | 1 | 16.693 | 0 | 16.706 | 6.844 |  | 1.000
20002.92308 | 1.999984618 | -87.631 | -104.324 | -118.347 | 1.209664262e-06 |  | 6.078429025e-06
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
