rjiuzzol/True8Digit/COPA/dataset_1/Results_20240613_THD/Board_1/THD_Board_1.png

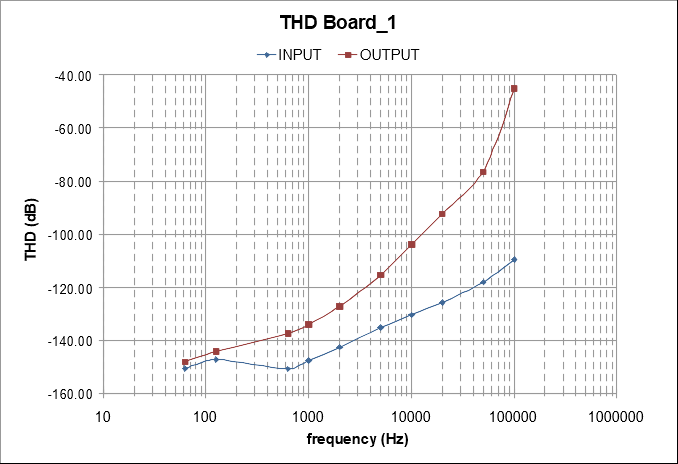
COPA/dataset_1/Results_20240613_THD/Board_1/THD_Board_1.png
