rjiuzzol/True8Digit/AD4630-24/dataset/ENOB/enob_fig.pdf

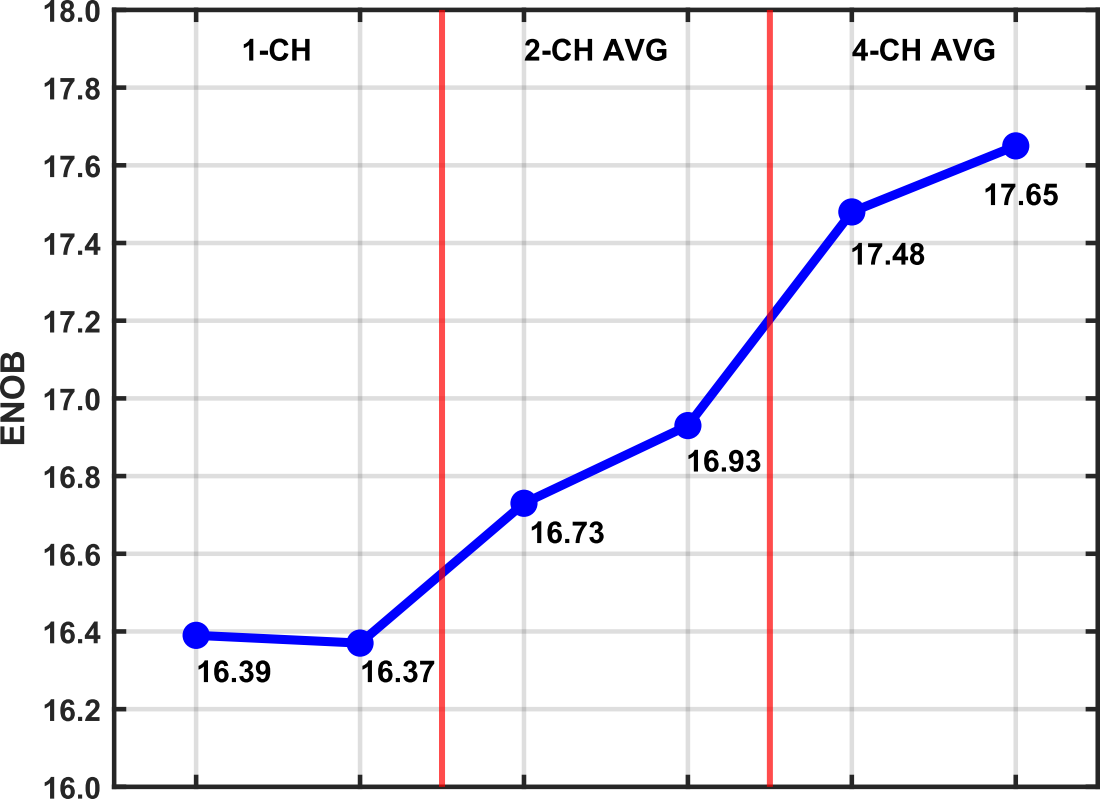
[picture p100: page 1]
