rjiuzzol/True8Digit/IADC/Simulations/DualSlope/LTSpice/3_amp_int_drafta_mod.asc

1n: cap; 470n
C2: cap; 470p
C3: cap; 3n; IC=0
C5: cap; 3.3p
C6: cap; 10p
C7: cap; 470p; IC=0
Q2: npn; BFR93A
R2: res; 4.7
R3: res; 20k
R4: res; 1.5k
R5: res; 150
R6: res; 75
R7: res; 1k
R8: res; 51
R9: res; 51
R10: res; 1.5k
R11: res; 20k
R12: res; 100Meg
R13: res; 470
U1: OPA828
U2: OPA189
U3: AD8065
Named nets: 0, V+5, V-5, IN, OUT
R12 is for simulation only
(introduces false pole)
.inc MetAmp.lib
