rjiuzzol/True8Digit/IADC/Simulations/DualSlope/LTSpice/Dualslope_IntHP_RJI_v1b.asc

A1: dflop; td=0.1n; Vhigh={VDD}
A2: inv; Vhigh={VDD}
A3: or; Vhigh={VDD}
A4: and; Vhigh={VDD}
A5: and; Vhigh={VDD}
A6: and; Vhigh={VDD}
B1: bv; V=If(V(meas)<0,-{VREF},{VREF}}
E1: e2; 1
R1: res; 10k
R2: res; 5k
R3: res; 5k
R4: res; 10k
S1: sw; sw1
S2: sw; sw1
S3: sw; sw1
S4: sw; sw1
S7: sw; sw1
U1: opamp; comp
V1: voltage; PULSE(0 {VDD} {1/f1} 1p 1p {Tint} {Tsamp})
V2: voltage; PULSE(0 {VDD} {{1/f1}+{Tint}-1n} 1p 1p {{Tsamp}-{Tint}} {Tsamp})
V3: cell; {VCC}
V4: voltage; PULSE(0 {VDD} 0 1n 1n {0.5/f1} {1/f1})
V5: cell; {VDD}
V6: cell; {VEE}
V7: voltage; PULSE(0 {VDD} 0 1p 1p {1/f1} {Tsim})
Vmeas1: voltage; SINE({Voff} {AMP} {Fsig}); AC 1
Vref2: voltage; {VREF}
X1: Int_HP3458_RI_mod
Named nets: 0, sw_meas, sw_ref, clk1, meas, int1, +V, -V, VDD, ff_reset, sw_zero, Vtest, Vref1, CountM, CountR, not_meas
.options plotwinsize=0
* SWITCH
.model sw1 SW(Ron=10 Roff=1G Vt=2.5V Vh=0)
System clock f1
integrate
integrator
reference
.ac dec 100 0.1Hz 100Meg
.param f1=2Meg
.param Tsim={1/Fsig}
.param Tint = 50u
.param Fsamp=8*{Fsig}
.param Tsamp={1/Fsamp}
.param Fsig=1kHz
.param VDD=5V
.param Voff=2.5V
.param AMP=2.5V
.model sw2 SW (Ron=10 Roff=1G Vt=1mV Vh=6u)
.param VREF=5V
.param VCC=15V
.param VEE=-15V
.options gminsteps=0 plotwinsize=0 itl6=0
.op
.tran 0 220u 2u 10u
;.tran 0 105u 5u 1n uic
integrate
reset
.tran 0 {Tsim} 2u 10u
;.tran 0 105u 5u 1n uic
.tran 0 {Tsim} 10u 1u
.options gmin=1e-10
.options abstol=1e-10
.options reltol=0.003
.options cshunt=1e-15
* COMPARATOR,  output limited to 0/5V, small hysteresis added
.subckt comp in- in+ out
.param V0=100000
.param Rout=100
B1 0 out I=limit( ( 0, (V(in+)-V(in-)+5e-4*V(out))*{V0/Rout}),  ({5/Rout}) )
Ro out 0 {Rout}
.ends
