rjiuzzol/True8Digit/IADC/Simulations/DualSlope/LTSpice/Ideal_Integrator_mod.asc

C1: cap; 330p; ic=0V
R1: res; 50k
R2: res; 1G
U1: opamp
Named nets: 0, Out, In
* OPAMP, output limited to +/-5V
.subckt opamp in- in+ out
.param V0=100000
.param Rout=100
B1 0 out  I=limit( ({-5/Rout}), ((V(in+)-V(in-))*{V0/Rout}),  ({5/Rout}) )
Ro out 0 {Rout}
.ends
