rjiuzzol/True8Digit/IADC/Simulations/DualSlope/LTSpice/Int_HP3458_RI_mod.asc

C1: cap; 100p; ic=0V
C2: cap; 100p; ic=0V
C3: cap; 2.2µ
C4: cap; 330p; ic=0V
C5: cap; 470p
C6: cap; 430p
J1: njf; U308
R1: res; 475
R2: res; 1.5k
R3: res; 33.2k
R4: res; 100
R5: res; 243
R6: res; 60
R7: res; 50k
R8: res; 10Meg
U1: LT1001
U2: UniversalOpAmp4; Avol=3000 GBW=50Meg Slew=300Meg
U3: opamp2; AD848
Named nets: -V, +V, 0, OUT, IN
.lib AD848.lib
