rjiuzzol/True8Digit/IADC/Simulations/DualSlope/LTSpice/Dualslope_Integrating_RJI.asc

A1: dflop; td=0.1n; Vhigh={VDD}
A2: inv; Vhigh={VDD}
A3: or; Vhigh={VDD}
A4: and; Vhigh={VDD}
A5: and; Vhigh={VDD}
C1: cap; 330p
E1: e2; 1
R1: res; 50k
R2: res; 50k
R3: res; 10k
S1: sw; sw1
S2: sw; sw1
S3: sw; sw1
S4: sw; ""
S5: sw; ""
U1: opamp
V1: voltage; PULSE(0 {VDD} 0 1p 1p {1/f1} {Tsim})
V2: voltage; PULSE(0 {VDD} {1/f1} 1p 1p {Tint} {Tsamp})
V4: voltage; PULSE(0 {VDD} 0 1p 1p {0.5/f1} {1/f1})
V5: cell; {VDD}
Vmeas1: voltage; SINE({Voff} {AMP} {Fsig}); AC 1
Vref1: voltage; {VREF}
Named nets: 0, sw_meas, sw_ref, sw_zero, VDD, ff_reset, clk1, meas, int1, CountM, CountR
.options plotwinsize=0
* SWITCH
.model sw1 SW(Ron=10 Roff=1G Vt=2.5V Vh=0)
System clock f1
reset
integrate
integrator
reference
.ac dec 100 0.1Hz 100Meg
.param f1=2Meg
.param Tsim={1/Fsig}
.param Tint = 40u
.param Fsamp=8*{Fsig}
.param Tsamp={1/Fsamp}
.param Fsig=1k
.tran 0 {Tsim} 10n 10u uic
;.tran 0 105u 5u 1n uic
.param VDD=5V
.param Voff=1
.param AMP=1
Comparator
.model sw2 SW (Ron=10 Roff=1G Vt=5uV Vh=1u)
* OPAMP, output limited to +/-10V
.subckt opamp in- in+ out
.param V0=100000
.param Rout=100
B1 0 out  I=limit( ({-10/Rout}), ((V(in+)-V(in-))*{V0/Rout}),  ({10/Rout}) )
Ro out 0 {Rout}
.ends
.param VREF=10V
